TimGotzel/Stumpfkoerper-WS-18-19/README.md

# Stumpfkoerper-WS-18-19
Projektarbeit im WS 18/19 zum Thema: Experimentelle Untersuchung des Coandaeffekts zur Reduktion von Strömungsverlusten an D-Stumpfkörpern
