TimGotzel/Stumpfkoerper-WS-18-19/20_Bericht/04_widerstandsbestimmung.tex

\chapter{Mathematische Vorgehensweise (FT)}\label{s:widerstandsbestimmung}

%Das Ziel dieser Arbeit ist es, festzustellen, ob die hybride aktive Str"omungsbeeinflussung von stumpfen K"orpern mittels gepulster Druckluftjets "uber zwei rotierende Coand\^{a}-Walzen mit kleiner Zahnzahl an der K"orperr"uckseite eine nennenswerte Widerstandsreduktion gegen"uber dem Fall ohne Beeinflussung erzielt. 
%Dar"uber hinaus soll getestet werden, ob die periodische Aktuierung gegen"uber vorherigen Untersuchungen mit kontinuierlicher Ausblasung den Widerstand  st"arker senken kann und diese Form der Ausblasung als effizienter betrachtet werden kann.

Damit das Ziel der Arbeit erreicht werden kann, m"ussen aus den Versuchsdaten die jeweiligen Widerstandswerte des K"orpers bestimmt werden. Dar"uber hinaus ist es erforderlich, abzusch"atzen, ob die gew"ahlte Form der Str"omungsmodifikation unter dem Schlussstrich Energie einsparen kann, oder, ob f"ur die Aktuationsmechanismen m"oglicherweise sogar mehr Energie aufgewandt werden muss, als an Einsparung gewonnen werden kann.\\
Zus"atzlich ist es von Interesse zu bestimmen, wie gro\ss{} der Impulsstrom ist, der durch die Aktuation in die Str"omung eingebracht wird und diesen ad"aquat zu kennzeichnen. 

Die Gleichungen f"ur diese Zwecke sollen in diesem Kapitel hergeleitet und n"aher erl"autert werden.

\section{Bestimmung des Widerstands mittels des Impulssatzes}
\label{sec:WueberImpulssatz}
%Die nachfolgenden Ausf"uhrungen orientieren sich eng an  Hucho \cite{Hucho.2011}.
Wie in \kap{s:grundlagen} beschrieben, besteht die Widerstandskraft $W$ eines K"orpers innerhalb einer Unterschallstr"omung im Wesentlichen aus den beiden Anteilen Reibungswiderstand und Druckwiderstand:
	\begin{equation}
	\label{eq:W_zusammensetzung}
	W = W_R + W_D
	\end{equation}
Bei schlanken K"orpern dominiert der Reibungswiderstand $W_R$ der aus Schubspannungen in der Grenzschicht der Geometrie resultiert. Bei stumpfen K"orpern hingegen ist in fast allen F"allen der Druckwiderstand $W_D$ f"ur den gr"o\ss{}eren Anteil verantwortlich. $W_D$ hat seinen Ursprung wie bereits erw"ahnt in einer "uber den K"orper schwankenden Druckverteilung.  

Bei der Untersuchung in dieser Arbeit sollen diese beiden Anteile im Folgenden jedoch nicht explizit auseinandergehalten bzw. separat bestimmt werden, da dies f"ur das Aufzeigen und Quantifizieren des ver"anderten Verhaltens durch aktive Str"omungskontrolle nicht notwendig ist.  Wir behandeln im Folgenden also nur die gesamte Widerstandskraft.

Der Widerstand $W$ eines stumpfen K"orpers innerhalb einer Str"omung macht sich als Impulsverlust stromabw"arts der umstr"omten Geometrie bemerkbar~\cite{Hucho.2011}. In \abb{fig:HuchoKV} sieht man diesen Sachverhalt durch die Delle im Geschwindigkeitsverlauf hinter dem K"orper veranschaulicht. %Die Auspr"agung dieser Delle wird 

Aus diesen "Uberlegungen folgt, dass die gesuchte Gr"o\ss{}e $W$ bestimmt werden kann, indem der Geschwindigkeitsverlauf der Str"omung im Nachlauf betrachtet und mittels des Impulssatzes ausgewertet wird. 

Der Widerstand des K"orpers selbst l"asst sich also finden, wenn ein Kontrollvolumen wie in \abb{fig:HuchoKV} um den K"orper gelegt und eine Impulsbilanz aufgestellt wird~\cite{Hucho.2011}. Es wird im Folgenden vereinfacht von einer horizontalen, inkompressiblen 2D-Str"omung ausgegangen und der Impulssatz in x-Richtung

\begin{equation}
	\label{eq:impulssatz_allg}
	\rho \int_{(K)} u_x \, \mathrm{d}Q = F_{Kx} + F_{Px} + F_{Sx}
\end{equation}
betrachtet.

Die Dichte der umstr"omenden Luft wird hierbei mit $\rho$ und die x-Komponente des Geschwindigkeitsvektors mit $u_x$ und der "uber die Kontrollfl"ache tretende Volumenstrom mit $Q$ bezeichnet.
Zudem entspricht in \glg{eq:impulssatz_allg} $F_{Kx}$ den angreifenden Volumenkr"aften, $F_{Px}$ der am freien Teil des Volumen angreifenden Oberfl"achenkr"afte (Druckkraft) und $F_{Sx}$ der St"utzkraft.

\begin{figure}[h]
	\centering
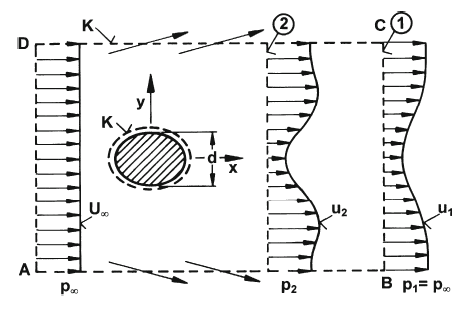
[picture p1: 20_Bericht/figures/KontrollvolumenHucho.PNG]
	
	\caption{Kontrollvolumen K um einen K"orper mit Geschwindigkeitsverteilungen u(x,y)~\cite{Hucho.2011}}
	\label{fig:HuchoKV}
\end{figure}

Die Volumenkraft $F_{Kx}$ kann dabei zu null gesetzt werden, da die Str"omung in Richtung x horizontal verl"auft und folglich kein Gravitationseinfluss ber"ucksichtigt werden muss. Auch abgesehen von der Gewichtskraft wirken keine anderen Volumenkr"afte.

Wenn das Kontrollvolumen, wie es in \abb{fig:HuchoKV} zu sehen ist, weit genug ab vom K"orper gelegt ist, herrscht an den Begrenzungr"andern AD, BC, AB und DC der konstante Druck $p_{\infty}$.
Dies resultiert in einer Druckkraft $F_{Px} = 0$, da sich die Kr"afte an den R"andern gegenseitig aufheben.

Infolgedessen kann die St"utzkraft nun also dem Nettoimpulsfluss gleichgesetzt werden, der
\begin{equation}
	\label{eq:nettoimpulsfluss}
	\rho \int_{(K)} \, u_x \, \mathrm{d}Q	= -\rho b \int u_1(U_{\infty} - u_1) \mathrm{d}y = F_{Sx}.	
\end{equation}
lautet.\\
Hier ist $b$ die Breite des Modells senkrecht zur Zeichenebene $u_1$ die Geschwindigkeit am Querschnitt (1) und  $U_{\infty}$ die Geschwindigkeit der umgest"orten Anstr"omung.

Die St"utzkraft des festen Teils des Kontrollvolumens - also des Stumpfk"orpers - h"angt mit dem Widerstand in der Form
\begin{equation}
	\label{eq:W=-F_Sx}
	W = - F_{Sx}
\end{equation}
zusammen.\\
$W$ ist also gleich der St"utzkraft mit negativem Vorzeichen.

Daraus folgt der Ausdruck f"ur den Widerstand zu
\begin{center}
	\begin{equation}
		\label{eq:widerstand}
		W = \rho b \int u_{1} (U_{\infty}- u_{1}) \mathrm{d}y.
	\end{equation}
\end{center}

Der Widerstand l"asst sich f"ur bessere Vergleichbarkeit dimensionslos "uber den Widerstandsbeiwert $C_w$ ausdr"ucken. Dieser ist als 
\begin{center}
	\begin{equation}
		\label{eq:def-c_w}
		C_w = \frac{W}{\frac{\rho}{2}\, U_{\infty}^2 \, bd}
	\end{equation}
\end{center}
definiert. Dabei wird der Widerstand auf die Str"omung und den charakteristischen K"orperquerschnitt $bd$ mit $d$ als H"ohe des Modells bezogen.

Nach Einsetzen der Gleichung \ref{eq:widerstand} ergibt sich f"ur den Widerstandsbeiwert
\begin{equation}
	\label{eq:Bestimmungsgleichung C_w}
	C_w = \frac{2}{U_{\infty}^2 d} \int u_{1}(U_{\infty} - u_{1}) dy.
\end{equation}
%Die Integrationsgrenzen m"ussen an die vertikale Ausdehnung der Sonden am Messrechen im Nachlauf angepasst werden.	

Um den Geschwindigkeitsverlauf zu bestimmen, k"onnen mehrere Methoden angewandt werden, wobei im Rahmen dieser Arbeit die Geschwindigkeiten aus den dynamischen Dr"ucken ermittelt werden.\\
Der Messrechen im Nachlauf liefert hierzu statische Dr"ucke und Totaldr"ucke.

Da die Wirbel an der K"orperr"uckseite periodisch abl"osen, erwarten wir am Ort der Messungen - sprich im Nachlauf - ebenfalls periodische Druckschwankungen.
Von Relevanz f"ur die zu untersuchenden Fragestellung sind dabei allerdings nur die Mittelwerte dieser Messungen "uber mehrere Perioden.
Diese werden fu"r die einzelnen Sonden in der Form
\begin{center}	
	\begin{equation}
		\overline{p}=\sum_{i=0}^{n}\frac{p_i}{n}
	\end{equation}
\end{center}
zeitlich gemittelt.
Die Summe aller "uber einen Zeitraum genommenen Dr"ucke $p_i$ wird hierbei durch die Anzahl $n$ dieser Dr"ucke innerhalb dieses Zeitraums geteilt.
Diese Mittlung gleicht zudem in gewissem Ma\ss{}e das unvermeidbare Messrauschen aus.

"Uber den die Definition des dynamischen Drucks $q$ bzw. den Zusammenhang
\begin{center}
	\begin{equation}
		\label{geschwindigkeitsformel}
		u_{1}(y)= \sqrt{\frac{2}{\rho}(p_t - p_{\infty}) } = \sqrt{\frac{2}{\rho} q(y)}
	\end{equation}
\end{center}
l"asst sich wie oben beschrieben der Geschwindigkeitsverlauf aus den gemessenen Dr"ucken bestimmen und in \glg{eq:Bestimmungsgleichung C_w} einsetzen. 

Wobei $p_t$ der Totaldruck, $p_{\infty}$ der statische Druck der freien Anstr"omung und $q$ der dynamische Druck ist.\\
Mit Hilfe dieser Formeln kann nun eine m"ogliche Reduktion des Widerstandsbeiwertes festgestellt werden.

Diese gesamte Vorgehensweise zur Bestimmung des Widerstands ist legitim, wenn an der Messstelle im Nachlauf n"aherungsweise angenommen werden kann, dass der statische Druck wieder $p_\infty$ entspricht.In diesem Fall heben sich die Druckterme im Impulssatz auf  beiden Seiten des Kontrollvolumens gegenseitig auf.
Wird die Nachlaufdelle hingegen n"aher am K"orper gemessen, weicht der dort gemessene statische Druck von $p_{\infty}$ ab.
Solche Abweichungen lassen sich durch die messtechnische Anordnung h"aufig nicht vermeiden - 
k"onnen nach \textit{B.M. Jones} aber durch eine Korrektur ber"ucksichtigt werden, wie sie beispielsweise bei \textit{Schlichting} \cite{Schlichting.2001} zu finden ist.

Hierbei werden die Dr"ucke, die theoretisch an einem Querschnitt (1) \abb{fig:HuchoKV} weit genug weg vom K"orper und somit von der statischen Druckabweichung herrschen, auf Dr"ucke zuruckgef"uhrt, die n"aher am K"orper tats"achlich gemessen werden\cite{Schlichting.2001}.
Der neue Querschnitt, bei welchem die Messung stattfindet, erh"alt den Index $(2)$.

Der Widerstand in diesem Fall ergibt sich zu
\begin{equation}
	\label{eq:widerstand_korrigiert}
	W = 2\,b \int \sqrt{p_{t2}(y) - p_2(y)} \left(\sqrt{p_{t\infty} - p_{\infty}} - \sqrt{p_{t2}(y) - p_{\infty}}\right) \mathrm{d} y_2 .
\end{equation}
Wobei $p_{t2}$ und $p_{t\infty}$ dem Totaldruck im Nachlaufquerschnitt respektive dem Totaldruck der ungest"orten Anstr"omung entspricht.

F"ur den Widerstandsbeiwert erh"alt man
\begin{equation}
	\label{eq:C_w_korrigiert}
	C_w = 2 \int_{(2)} \sqrt{\frac{p_{t2}(y) - p_2(y)}{q_{\infty}}}
	\left(1 - \sqrt{\frac{p_{t2}(y) - p_{\infty}}{q_{\infty}}}\right)  \mathrm{d}\left(\frac{y_{2}}{d}\right).
\end{equation}

Der Rechen, der die Dr"ucke liefert, sollte zu diesem Zwecke m"oglichst so platziert werden, dass die Nachlaufdelle komplett aufgenommen wird. 

Da nur diskrete Werte der jeweiligen Druckverteilung auf diese Weise ermittelt werden, m"ussen die Druckverteilungen durch eine Fitting-Funktion angen"ahert werden. 
Hierzu eignet sich - der bisherigen Erfahrung nach - der Ansatz

	\begin{equation}
	\label{eq:fitting-function}
	\frac{p(y) - p_{\infty}}{p_{min}-p_{\infty}} = (1 +ay^2)^{by^2}.
	\end{equation}
In \glg{eq:fitting-function} entspricht $p_{min}$ dem niedrigsten Druck im Nachlauf und $a$ und $b$ sind Modellparameter \cite{Oswald.2017}.

Diese Vorgehensweise hat sich beispielsweise bei einem "ahnlichem Modell durch \textit{Oswald} bew"ahrt \cite{Oswald.2017}.

Die \textit{Matlab}-Funktion \textit{nlinfit} wird hierbei genutzt, um die g"unstigsten Parameter f"ur die Druckverteilungen durch nichtlineare Regression zu bestimmen.\\
Die von \textit{nlinfit} ermittelten Druckverteilungen k"onnen dann zur Bestimmung des Widerstandsbeiwerts in \glg{eq:C_w_korrigiert} eingesetzt werden.\\
F"ur die Aufl"osung des Integrals wird die \textit{Matlab}-Funktion \textit{integral} genutzt, die globale adaptive Quadratur zur numerischen Bestimmung des Integralwerts einsetzt~\cite{Oswald.2017}.

Der vollst"andige \textit{Matlab}-Code zur Berechnung des Widerstandsbeiwerts und der Druckverteilungen ist in Anhang \ref{C_w-Code} zu finden. 

%---------------------------------------------------------------------------------------------------------------------------------------------------------------------------------
\section{Impulskoeffizient und Effizienzbetrachtung}

\subsection{Impulskoeffizient}
Der Impulskoeffizient $C_{\mu}$ wird als Ma\ss{} f"ur die Intensit"at der Ausblasung verwendet und ist im Falle von kontinuierlicher Ausblasung als 
\begin{equation}
	\label{eq: Def-momentum-coeff}
	C_{\mu} = \,\frac{\dot{m}_{jet} \cdot U_{jet}}{\frac{1}{2}\rho_{\infty}\, \cdot U^2_{\infty} \cdot A_{ref}}
\end{equation}
definiert~\cite{ElSayedM..2018}. 
Dabei entspricht $\dot{m}_{jet}$ dem Massenstrom, der durch die Spalte ausgeblasen wird. $U_{jet}$ bezeichnet die Geschwindigkeit dieses Ausblasestroms.
$A_{ref}$ wiederum dient als Bezugsfl"ache. Im Falle des getesteten Stumpfk"orpers wird als $A_{ref}$ die projizierte Fl"ache der K"orperh"ohe verwendet, da beispielsweise der Druckwiderstand einen proportionalen Zusammenhang zu dieser, f"ur stumpfe K"orper, charakteristischen Fl"ache besitzt.  %\cite{Bilges.2018}

Die Periodizit"at der Ausblasung, wie sie im Fall der zweiten Versuchskonfiguration auftritt, kann zus"atzlich im Impulskoeffizienten ber"ucksichtigt werden und f"uhrt letzendlich auf die Form \cite{Chabert.2014}
\begin{equation}
	\label{eq:momentum-coeff-oscill}
	\langle{C_{\mu}}\rangle = \frac{\rho_{jet}\langle{U^2_{jet}}\rangle \langle{A_{Spalt}}\rangle} {\frac{1}{2}\rho_{\infty}U^2_{\infty}A_{ref}}.	
\end{equation}
In \glg{eq:momentum-coeff-oscill} steht der $\langle{}\rangle$-Operator f"ur die jeweiligen zeitlichen Mittelwerte und $A_{Spalt}$ bezeichnet die Fl"ache des Ausblasespalts.

Da sowohl Plenumsdruck und somit auch die Ausblasegeschwindigkeit $U_{jet}$, als auch der Spaltquerschnitt "uber die Umdrehung der Walzen schwanken, m"ussen diese Einfl"usse wie in \glg{eq:momentum-coeff-oscill} Eingang in die Formel f"ur $C_{\mu}$ im Falle der periodischen Aktuation finden.

F"ur das mit der Zeit variierende $A_{Spalt}$   wird die mittlere Spalth"ohe, die sich von dem Zeitpunkt der "Offnung des Spalts bis zu dem Zeitpunkt, an dem der Spalt gerade wieder geschlossen ist, ermittelt.  
Durch die Betrachtung des in \kap{s:rotierendeWalzen} in \abb{fig:signal} dargestellten Spalth"ohenverlaufs ergibt sich ein $\langle{h_{Spalt,offen}}\rangle$ von ca. 0,19 \,mm.

Die mittlere Spalth"ohe "uber eine komplette Umdrehung ergibt sich durch die Multiplikation mit dem Tastgrad $\alpha$.

$U_{jet}$ muss im Falle der neu erprobten Testkonfiguration mit ovalen Wellen "uber die Plenumsdr"ucke berechnet werden.
Zun"achst werden aus den kontinuierlich ermittelten Messwerten f"ur die beiden Dr"ucke $p_{Plenum}$ mittlere Werte gebildet, die als Ausgangspunkt der Berechnung dienen.

Wir gehen weiterhin davon aus, dass der im Plenum vorhandene Druck vollst"andig in dynamischen Druck umgesetzt wird:
	\begin{equation}
	\label{eq:Annahme q}
		\langle{p_{Plenum}}\rangle = q_{jet}
	\end{equation}
In\glg{eq:Annahme q} ist $q_{jet}$ der dynamische Druck des Druckluftjets.

Da wir eine inkompressible Str"omung annehmen, kann die Geschwindigkeit $\langle{U_{jet}}\rangle$ nun als
	
	\begin{equation}
	\label{eq:jetgeschwindigkeit}
		\langle{U_{jet}}\rangle = \sqrt{\frac{2 \langle{p_{Plenum}}\rangle}{\rho_{jet}}} = \sqrt{\frac{2 \langle{p_{Plenum}}\rangle}{\rho_{\infty}}}
	\end{equation}
ausgedr"uckt werden.

Dar"uber hinaus muss wie bereits erw"ahnt der Tastgrad (\textit{engl}: duty cycle) des Signals der Walzen $\alpha$  mitbetrachtet werden.
Bei den getesteten Walzen folgt f"ur 50\,\% Tastgrad, dass die Ausblasung zumindest theoretisch exakt "uber die H"alfte einer Walzenumdrehung erfolgt.
%Daraus folgt f"ur den Impulskoeffizient mit Ber"ucksichtigung der Periodizit"at die Gleichung
%\begin{equation}
%	\label{eq:momentum-coeff-oscill-alpha}
%	\langle{C_{\mu}}\rangle = \alpha C_{\mu}
%\end{equation}	 

Wenn nun zus"atzlich bedacht wird, dass "uber zwei als gleich angen"aherte Spalte ausgeblasen wird, k"urzt sich dieser Faktor 2 genau mit dem Tastgrad und wir erhalten als modifizierten Impulskoeffizienten f"ur die zweite Testkonfiguration

	\begin{equation}
	\label{eq:momentum-coeff-oscill-final}
		\langle{C_{\mu}}\rangle = \frac{\rho_{jet}\langle{U^2_{jet}}\rangle \langle{A_{Spalt}}\rangle} {\frac{1}{2}\rho_{\infty}U^2_{\infty}A_{ref}} = \frac{2\langle{p_{Plenum}}\rangle \langle{h_{Spalt,offen}}\rangle \cdot b_{Spalt}} {\frac{1}{2}\rho_{\infty}U^2_{\infty}A_{ref}}
	\end{equation}

Mittels des Impulskoeffizienten kann die Effektivit"at der Ausblasung beschrieben werden.
Auch f"ur den Vergleich zwischen den untersuchten Walzenpaaren und mit den Daten von \textit{Bilges} \cite{Bilges.2018} ist die Betrachtung des Impulskoeffizienten ma\ss{}geblich.

\subsection{Leistungskoeffizient und Leistungsrate}
Eine alleinige Betrachtung und ein Vergleich der $C_w$-Werte f"ur den Fall ohne Druckluftzuf"uhrung und rotierende Walzen, sowie den Fall mit aktiver konstanter sowie periodischer Stro"mungsbeeinflussung ist nicht ausreichend, um eine vollst"andige Bewertung der unterschiedlichen Konfigurationen vorzunehmen.

Die durch eine Widerstandsreduktion bedingte Leistungseinsparung im Anwendungsfall k"onnte durchaus durch die extern aufzubringende Leistung f"ur Druckluft und Walzenrotation ausgeglichen oder "ubertroffen werden, sodass letztendlich zus"atzliche Energie aufgebracht und der Zweck der Anwendung verfehlt w"urde.

Ob diese Form der Str"omungsbeeinflussung also eine reale Netto-Leistungseinsparung zur Folge hat, muss folglich durch andere Kennzahlen quantifiziert werden.

Zun"achst verwenden wir f"ur die Effizienzbetrachtung eine Leistungsrate $PR$, die als 

\begin{equation}
	\label{eq:leistungsrate}
	PR = \frac{(W_0 - W)\cdot U_{\infty}}{\frac{1}{2} \dot{m_j} u_j^2 + \, P_M}
\end{equation}
eingef"uhrt wird~\cite{Freund.1994}.

Der Z"ahler dr"uckt die eingesparte Widerstandsleistung des Falls mit aktiver Str"omungsbeeinflussung im Vergleich mit dem neutralen Fall aus.
Dieser Term quantifiziert somit, in welchem Umfang die Energiedissipation in der Str"omung im zweiten Versuch reduziert wird.

Der Nenner repr"asentiert hingegen die Leistung welche dem Modell bzw. der Str"omung von externer Quelle zugef"uhrt werden muss, um den gew"unschten Effekt zu erzielen.

Der erste Summand $\frac{1}{2}\,\dot{m_j} u_j^2$ charakterisiert die kinetische Leistung der Druckluft-Jets, die durch die Spalte ausgeblasen werden. Diese Darstellung vernachl"assigt, dass die  Druckluftbeaufschlagung in den Leitungen Verluste mit sich tr"agt und auch der Kompressor selber keinen optimalen Wirkungsgrad besitzt. Somit handelt es sich bei diesem Term um die idealisierte Jet-Leistung.

Der zweite Summand $ P_M$ ist die kombinierte Motorleistung und tr"agt dem Zustand Rechnung, dass die rotierenden Walzen von zwei Elektromotoren angetrieben werden m"ussen. Diese sind f"ur den Ausgleich der an den Walzen auftretenden Widerst"anden wie Reibung an den Lagern zust"andig.
Diese Leistung wird mittels eines Leistungsmessger"ats ermittelt und manuell f"ur die Versuchsreihen notiert.

Eine negative Leistungsrate kennzeichnet F"alle in denen der Widerstand gegen"uber der Referenzmessung gestiegen ist. Eine positive Leistungsrate unterhalb von $1$ ergibt sich bei Konfigurationen, bei denen zwar der Widerstand durch die Aktuation gesenkt werden, dieser Gewinn die Kosten aber nur anteilig ausgleichen kann.\\
Erst bei Leistungsraten oberhalb von $PR = 1$ wird durch die aktiven Ma\ss{}nahmen zur Widerstandsreduzierung eine tats"achliche Leistungsersparnis generiert.

Mit \glg{eq:def-c_w} kann man die Leistungsrate auch als
\begin{equation}
	\label{eq:leistungsrate_cw}
	PR = \frac{(C_{W0} - C_W)\cdot \frac{\rho_{\infty}}{2} U^3_{\infty}\,A_{ref}}{\frac{1}{2} \dot{m_j} u_j^2 + \, P_M}
\end{equation}
schreiben.

Des Weiteren wird noch als Gr"o\ss{}e der Leistungskoeffizient $C_{Power}$ ben"otigt, welcher als
\begin{equation}
	\label{eq:def-powercoefficient}
	C_{Power,jet} = \frac{E_{jet}\dot{m}_{jet} + p_{jet}U_{jet}A_{jet} - (E_p\dot{m}_p + p_p U_p A_p)}{\frac{1}{2}\rho_{\infty}U^3_{\infty} A_{ref}}
\end{equation}

mit
\begin{equation}
	\label{eq:def-energieterm}
	E = c_vT + \frac{U^2}{2}
\end{equation}		
definiert ist~\cite{Hucho.2011}.

Gr"o\ss{}en mit Index $p$ entsprechen dabei den Gr"o\ss{}en innerhalb des Plenums, in dem die Str"omung nicht kontrahiert wird.
Des Weiteren bezeichnet $c_v$ die spezifische W"armekapazit"at von Luft bei konstantem Volumen, $T$ die Temperatur der Luft und $U$ die Geschwindigkeit.

Dieser Koeffizient dr"uckt das Verh"altnis der aufzubringenden Leistung durch die Aktuation zur in der Antsr"omung vorhandenen Leistung aus.

Im Rahmen dieser Versuche wenden wir auf \glg{eq:def-powercoefficient} einige Vereinfachungen an. 

Zun"achst treffen wir die Annahmen, dass die Temperatur innerhalb des ausgeblasenen Luftstroms gleich der Temperatur im Plenum ist
	\begin{equation}
	\label{eq:T-Vereinfachung}
		T_{jet} = T_{Plenum}
	\end{equation}
und wir n"aherungsweise davon ausgehen k"onnen, dass im Plenum keine Str"omungsgeschwindigkeit 
	\begin{equation}
	\label{eq:Up}
		U_{Plenum} \approx 0
	\end{equation}
vorliegt.

Des Weiteren nehmen wir, wie zuvor, an, dass die Str"omung inkompressibel ist und somit
	\begin{equation}
	\label{eq:Inkompressibilitaet}
		\rho_{jet} = \rho_{Plenum} = \rho_{\infty}
	\end{equation}
gilt.

Damit folgt f"ur den Leistungskoeffizienten der Ausblasung

	\begin{equation}
	\label{eq:CPowerJ vereinfacht}
		C_{Power,Jet} = \frac{\frac{1}{2}\,U^2_{jet} \cdot \dot{m}_{jet} \, + p_{jet}U_{jet}A_{jet}}{\frac{1}{2}\rho_{\infty}U^3_{\infty}A_{ref}}.
	\end{equation}

Im Falle periodischer Ausblasung muss anstatt $A_{jet}$ wieder $\langle{A_{jet}}\rangle$ verwendet werden.

Neben der Ausblasung wird auch der Aktuation durch die Walzen ein Leistungskoeffizient zugewiesen, welcher als
		\begin{equation}
		\label{eq:def-CPowerM}
			C_{Power,M} = \frac{P_M}{\frac{1}{2}\rho_{\infty}U^3_{\infty}A_{ref}}
		\end{equation}
		
definiert wird.
$P_M$ entspricht hierbei wie zuvor der kombinierten Leistung der beiden Motoren.
