TimGotzel/Stumpfkoerper-WS-18-19/20_Bericht/00_eid_erkl.tex

\chapter*{Eidesstattliche Erkl"arung}\label{s:eid_erkl}

Wird eine eidesstattliche Erkl"arung ben"otigt?

%Hiermit erkl"are ich, Vorname Familienname, geb. am xx.yy.zzzz, des Eides
%statt, die vorliegende Diplom-/Master-/Bachelor-Arbeit selbstst"andig und ohne
%fremde Hilfe verfasst und keine anderen als die angegebenen Hilfsmittel verwendet zu
%haben.
%
%\vspace*{3cm}
%Braunschweig, xx.yy.zzzz
