TimGotzel/Stumpfkoerper-WS-18-19/20_Bericht/00_frontpage.tex

\begin{titlepage}
 \centering

\begin{table}[htbp]
 \begin{center}
 \vspace{-0.5cm}
% \renewcommand{\arraystretch}{1.5}
  \begin{tabular}{lcr} 
    \parbox{0.45\textwidth}{\mbox{ }} & \parbox{0.13\textwidth}{\mbox{ }} & \parbox{0.45\textwidth}{\mbox{ }} \\
    \hspace*{-2.0cm}
     & 
     &  \\ %empty
  \end{tabular}
 \end{center}
\end{table}

 \vspace*{2.0cm}

 \textbf{\large Projektarbeit}

 \vspace*{1.5cm}
 
 \textbf{\LARGE Experiment am D-f"ormigen Stumpfk"orper} \\[0.5ex]

 \vspace*{1.5cm}

 \textbf{\large Nora M. Bierwagen (Matr.-Nr. 4754262)} \\
 \textbf{\large Tim Gotzel (Matr.-Nr. 4839608)} \\
 \textbf{\large Amiriman Kianfar (Matr.-Nr. 4844004)} \\
 \textbf{\large Kebria Kiani (Matr.-Nr. 4676955)} \\
 \textbf{\large Florian Timm (Matr.-Nr. 4795072)} \\

 \vspace*{7.0cm}

 \begin{table}[htbp]
  \begin{center}
%  \renewcommand{\arraystretch}{1.5}
   \begin{tabular}{rl} 
     \parbox{0.33\textwidth}{\mbox{ }} & \parbox{0.66\textwidth}{\mbox{ }} \\
     Ausgegeben:%& Jun.-Prof. Dr.-Ing. D. Ko{\v z}ulovi{\' c} \\
                 & Institut f\" ur Str\" omungsmechanik \\
                 & Institutsleiter: Prof. Dr.-Ing. R. Radespiel \\
                 & Technische Universit\" at Braunschweig \\
                 &  \\
       Betreuer: %& Dipl.-Ing. X Y, (externe Firma) \\
                 & M.Sc. Philipp Oswald, (TU Braunschweig) \\
           %      &  \\
 %(Erstellt bei:) & (Externe Firma, Stadt) \\
                 &  \\
 Ver"offentlichung: & \today \\
   \end{tabular}
  \end{center}
 \end{table}

\end{titlepage}
