TimGotzel/Stumpfkoerper-WS-18-19/70_Poster/PAPoster.pptx

TUBraunschweig_CO_360vH_PPT_Poster

Institut für Strömungsmechanik

Widerstandsreduzierung am Stumpfkörper durch kombinierte, periodische Strömungsaktuierung
N. M. Bierwagen, T. Gotzel, A. Kianfar, K. Kiani, F. Timm
Technische Universität Braunschweig | Institut für Strömungsmechanik
Betreuer: M.Sc. Philipp Oswald, philipp.oswald@tu-braunschweig.de

Rotierende Walzen
Material PTFE & Aluminium
Durchmesser (maximal) 16,6 mm
Maximale Spaltöffnung 0,3 mm
Anzahl der Zähne 2
Duty Cycle 50%

Ergebnisse
Tendenz zu Widerstandsreduktionen im
Bereich oberhalb der natürlichen Ablöse-
Frequenz für gewisse Ausblaseparameter
Wegen hoher Reibungswiderstände keine
Leistungseinsparung durch Aktuations-
mechanismen
Abrieb an den Teflonwalzen


Stumpfkörper
Totwassergebiet mit Nachlauf durch zweiseitige Scherschicht
Hoher Druckwiderstand durch Druckabsenkung im Totwasser
Alternierend oszillierende Wirbelbildung
Strouhal-Zahl: Str= (f∙D)/(U_(∞))≈0,23
Nachlauf mit Informationen über
Druckwiderstand
Ziel:
Druckerhöhung im Totwasser
Hybride Aktuierung
      - Rotierende Walzen
      - Periodische Coandâ-Flächen
Ausblasung

Graphik aus: W.-H. Hucho. Aerodynamik der stumpfen Körper: Physikalische Grundlagen und Anwendungen in der Praxis. Strömungsmechanik. Vieweg + Teubner, Wiesbaden, 2., vollst. überarb. und erw. au. edition, 2011.


Widerstandsermittlung
Ermittlung der Druckverteilungen im Nachlauf des Modells durch Messrechen
Festlegung eines Kontrollvolumens
Aufstellen und Auswerten des Impulssatzes:
C_W =2∫_((2)) √((p_(t2) (y)−p_2 (y))/(q_(∞)))(1− √((p_(t2) (y)−p_(∞))/(q_(∞))))
Variation der Walzendrehzahl n und des Impulskoeffizienten C_μ


Graphik aus: W.-H. Hucho. Aerodynamik der stumpfen Körper: Physikalische Grundlagen und Anwendungen in der Praxis. Strömungsmechanik. Vieweg + Teubner, Wiesbaden, 2., vollst. überarb. und erw. au. edition, 2011.

Ausblick
Wechsel des Materials bzw. der Materialkombination am Ausblasespalt
Phasengleichheit der Walzen sicherstellen
Variation Zahnformen
Variation der Anzahl der Zähne
Variation des duty cycles
LKW-Modell mit Bodeneffekten

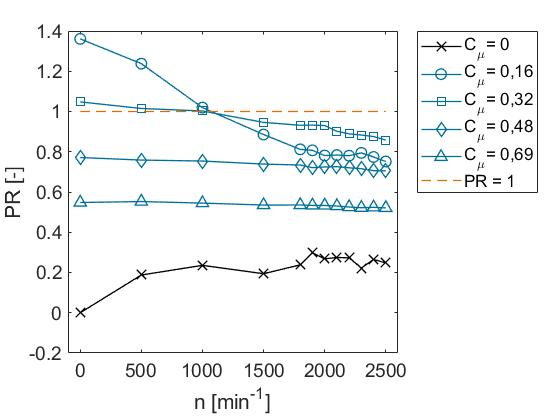
[picture p8: figure]
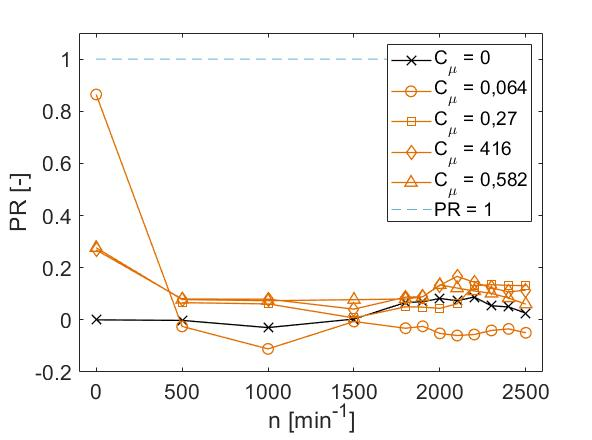
[picture p9: figure]
