TimGotzel/Stumpfkoerper-WS-18-19/20_Bericht/00_nomenklatur.tex

\chapter*{Nomenklatur}
\addcontentsline{toc}{chapter}{Nomenklatur}
%ALPHABETISCH SORTIEREN!

\subsection*{Lateinische Bezeichnungen}
\begin{tabbing}
\hspace*{2cm}\=\kill
%$AVDR$ \> axiales Stromdichteverh\"altnis \\[0.2ex]
$A$ \> Fl"ache/Querschnitt \\[0.2ex]
$b$ \> Breite des Modells senkrecht zur Zeichenebene \\[0.2ex]
$C_{Power}$ \> Leistungskoeffizient \\[0.2ex]
$C_w$ \> Widerstandsbeiwert \\[0.2ex]
$C_{\mu}$ \> Impulskoeffizient \\[0.2ex]
$D$ \> Dicke bzw. H"ohe des Stumpfk"orpers \\[0.2ex]
$dp$ \> Druckgradient \\[0.2ex]
$f$ \> Frequenz \\[0.2ex]
$F$ \> Kraft \\[0.2ex]
$F_{K}$ \> Volumenkr"afte \\[0.2ex]
$F_{P}$ \> Druckkr"afte \\[0.2ex]
$F_{S}$ \> St"utzkraft \\[0.2ex]
$H$ \> Strahlh"ohe \\[0.2ex]
$K$ \> Kontrollfl"ache \\[0.2ex]
$\dot{m}$ \> Massenstrom \\[0.2ex]
$n$ \> Drehzahl \\[0.2ex]
$P_M$ \> Motorleistung \\[0.2ex]
$p$ \> statischer Druck \\[0.2ex]
$p_t$ \> Totaldruck \\[0.2ex]
$p_Plenum$ \> Plenumsdruck \\[0.2ex]
$Q$ \> Volumenstrom \\[0.2ex]
$q$ \> Dynamischer Druck \\[0.2ex]
$R$ \> Radius der Coand\^{a}-Kontur \\[0.2ex]
$Str$ \> Strouhal-Zahl \\[0.2ex]
$U_{\infty}$ \> Anstr"omungsgeschwindigkeit \\[0.2ex]
$u_1$ \> Str"omungsgeschwindigkeit in x-Richtung \\[0.2ex]
$W$ \> Widerstand \\[0.2ex]
$x$ \> Koordinate in Str"omungsrichtung \\[0.2ex]
$y$ \> Koordinate senkrecht zur Str"omungsrichtung \\[0.2ex]
\end{tabbing}

\subsection*{Griechische Bezeichnungen}
\begin{tabbing}
\hspace*{2cm}\=\kill
$\alpha$ \> Tastgrad (\textit{engl.}: duty cycle) \\[0.2ex]
%$\beta$ \> Winkel in Umfangsrichtung \\[0.2ex]
$\lambda$ \> Schlankheitsgrad \\[0.2ex]
$\rho$ \> Dichte \\[0.2ex]
$\sigma$ \> Dickenverh"altnis \\[0.2ex]

\end{tabbing}

\subsection*{Indizes}
\begin{tabbing}
\hspace*{2cm}\=\kill
%$ax$ \> in axiale Richtung \\[0.2ex]
$\infty$ \> Freie Anstr"omung \\[0.2ex]
$0$ \> Bezugsr"o\ss{}e \\[0.2ex]
$1$ \> Gr"o\ss{}e im Str"omungsquerschnitt des Nachlaufs weit ab vom K"orper \\[0.2ex]
$2$ \> Gr"o\ss{}e im Str"omungsquerschnit in dem der Rechen angeordnet ist \\[0.2ex]
$C$ \> Gr"o\ss{}e an Zylinder \\[0.2ex]
$ref$ \> Referenzgr"o\ss{}e \\[0.2ex]
$jet$ \> Gr"o\ss{}e bez"uglich des augeblasenen d"unnen Luftstrahls (Jet) \\[0.2ex]
$M$ \> Gr"o\ss{}e bez"uglich der Motoren \\[0.2ex]
\end{tabbing}

\subsection*{Abk\"urzungen}
\begin{tabbing}
\hspace*{2cm}\=\kill
%$CFD$ \> \underline{C}omputational \underline{F}luid \underline{D}ynamics \\[0.2ex]
$NB$ \> \underline{N}ora M. \underline{B}ierwagen \\[0.2ex]
$TG$ \> \underline{T}im \underline{G}otzel \\[0.2ex]
$AK$ \> \underline{A}miriman \underline{K}ianfar \\[0.2ex]
$KK$ \> \underline{K}ebria \underline{K}iani \\[0.2ex]
$FT$ \> \underline{F}lorian \underline{T}imm \\[0.2ex]
%$MATLAB$ \> kommerzielle Software zur L"osung mathematischer Probleme\\[0.2ex]

$PR$ \> Leistungsrate \\[0.2ex]
$rpm$ \> Umdrehungen pro Minute \\[0.2ex]
\end{tabbing}
