TimGotzel/Stumpfkoerper-WS-18-19/20_Bericht/anhang2.tex

\chapter{MATLAB-Code (AK, FT)}
\label{c:Anhang B}

\section{Bestimmung der Druckverteilungen und des Widerstands}
\label{C_w-Code}
\begin{figure}[h]
	\centering
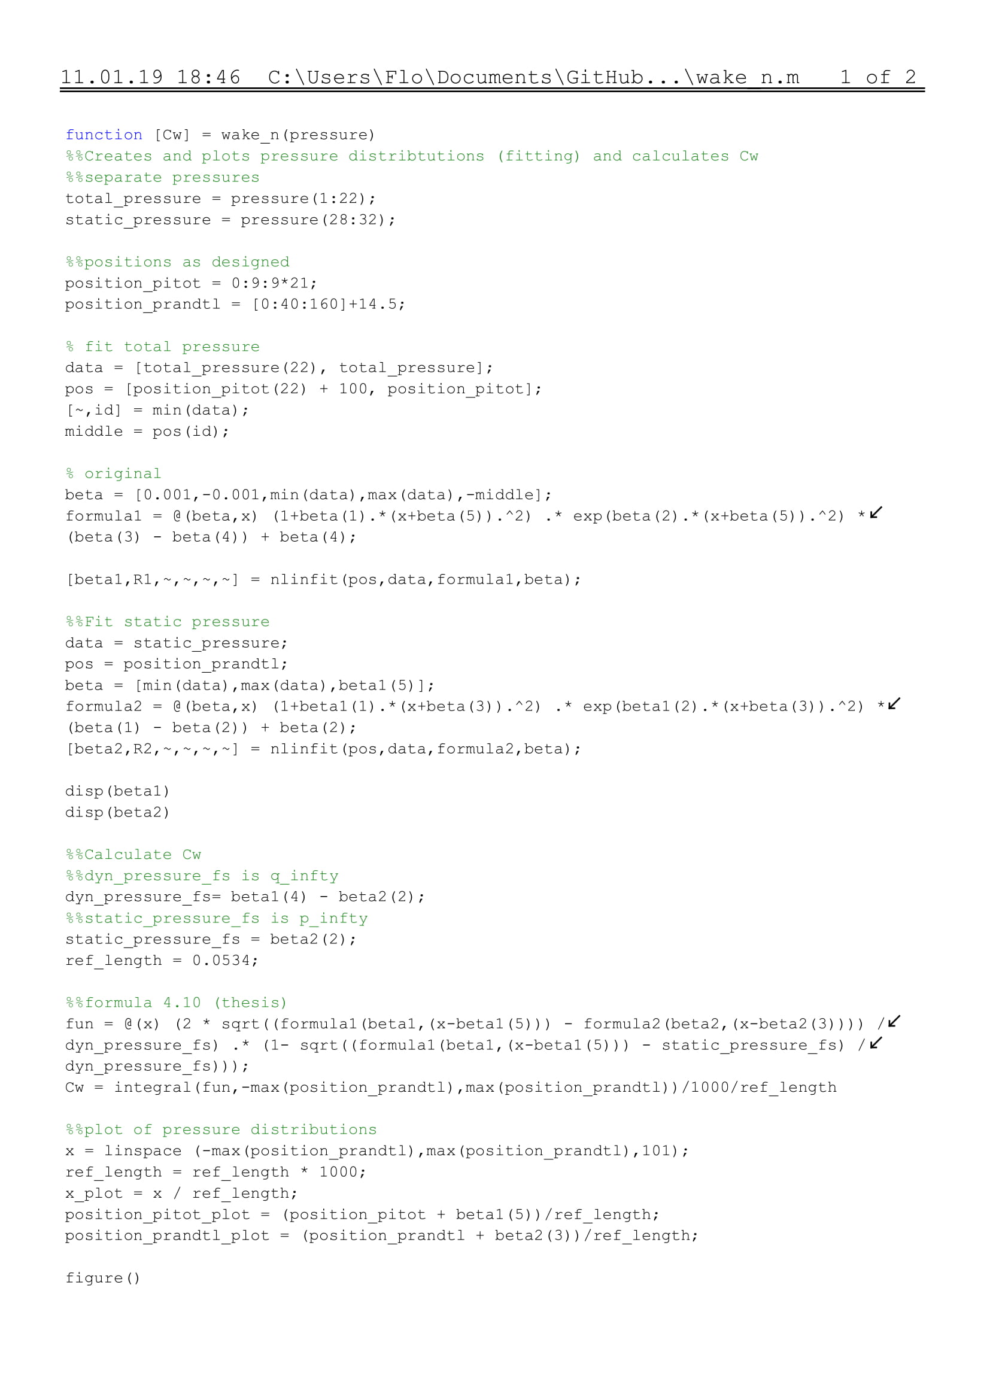
[picture p71: 20_Bericht/figures/wake_n-1.jpg]
	
	\label{fig:C_w-Code}
\end{figure}
\begin{figure}
	\centering
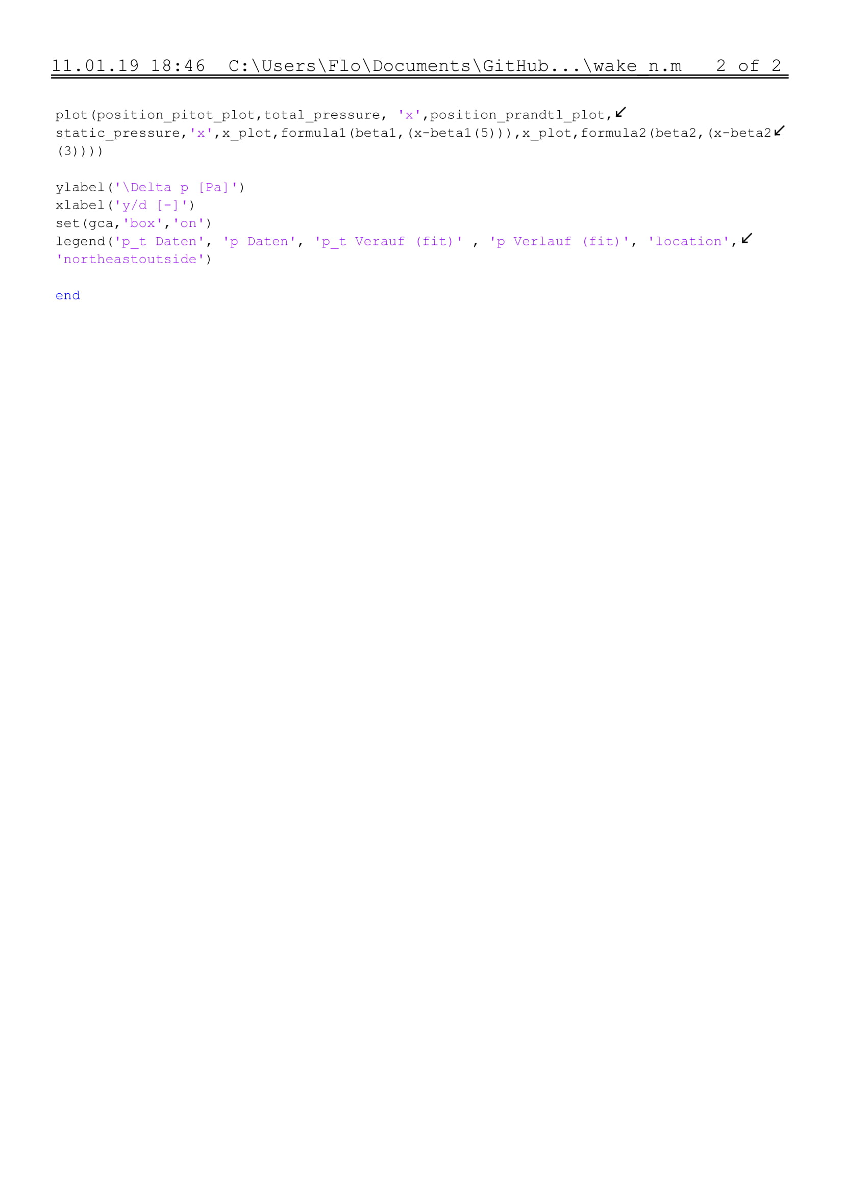
[picture p72: 20_Bericht/figures/wake_n-2.jpg]
	
\end{figure}
