TimGotzel/Stumpfkoerper-WS-18-19/20_Bericht/Berichtgliederung.docx

Berichtgliederung

Formelzeichen

Einleitung/Fragestellung

1. Grundlagen
  a. Stumpfkörperaerodynamik
  b. Coandâ-Effekt
  c. Aktive/passive Strömungsbeeinflussung
2. Rotierende Walzen
  a. Geometrie
  b. Konstruktion
  c. Motor
3. Widerstandsbestimmung
4. Windkanalversuche
  a. Windkanal
  b. Versuchsaufbau
  c. Messeinrichtungen
  d. Versuchsdurchführung
5. Versuchsauswertung
  a. Messdaten
  b. Vergleich mit Erwartungen
  c. Vergleich zum Modell ohne Walzen
  d. Effizienzbetrachtung
6. Fazit
7. Appendix
