TimGotzel/Stumpfkoerper-WS-18-19/90_Widerstandsbestimmung/Formeln zur Widerstandsbestimmung.pdf

# Kapitel 1

# Widerstandsbestimmung

Das Ziel dieser Arbeit ist es, festzustellen, ob die aktive Strömungsbeeinussung von stumpfen Körpern mittels gepulster Druckluftjets über zwei rotierende Coanda-Walzen an der Körperrückseite eine nennenswerte Widerstandsreduktion gegenüber dem Fall ohne Beeinussung erzielt.

Hierzu muss aus den Versuchsdaten einerseits die jeweiligen Widerstandswerte des Körpers bestimmt werden. Andererseits ist es erforderlich, abzuschätzen, ob diese Form der Strömungsmodikation unter dem Schlussstrich Energie einsparen kann oder für die Aktuationsmechanismen möglicherweise sogar mehr Energie aufgewandt werden muss, als an Einsparung gewonnen werden kann.

Die Gleichungen für diese Zwecke sollen in diesem Kapitel hergeleitet und erläutert werden.

## 1.1 Bestimmung des Widerstands mittels des Impulssatzes

Die nachfolgenden Ausführungen orientieren sich eng an Huchos Aerodynamik der stumpfen Körper (S.52 .).

Der Widerstand des umströmten Stumpfkörpers kann ermittelt werden, in dem der Geschwindigkeitsverlauf der Strömung im Nachlauf betrachtet und ausgewertet wird.

Die Messung im Windkanal im Nachlauf liefert hierzu diverse Drücke - statische und dynamische.

Damit wir unser vereinfachtes mathematisches Modell auf die Versuchsdaten anwenden können, müssen die Drücke der einzelnen Sonden in der Form

p =

Xn

i=0

pi
n

(1.1)

zeitlich gemittelt werden. Die Summe aller über einen Zeitraum genommenen Drücke pi wird hierbei durch die Anzahl n dieser Drücke innerhalb dieses Zeitraums geteilt.

Über den die Denition des dynamischen Drucks q bzw. den Zusammenhang

u1(y) = s

ρ

(pg − p∞) = s

ρ

q(y) | (1.2)

lässt sich der Geschwindigkeitsverlauf aus den gemessenen Drücken bestimmen.

Wobei u1 die Strömungsgeschwindigkeit im Nachlauf in Abhängigkeit der y-Koordinate und q der gemessene dynamische Druck ist.

Der Widerstand des Körpers selber lässt sich nun nden, wenn ein Kontrollvolumen um den Körper gelegt und der Impulssatz in x-Richtung nach der resultierenden Druckkraft ausgewertet wird, wobei der Ausdruck für den Widerstand

W = ρb Z +y

−y

u1(U∞ − u1)dy | (1.3)

wird. Hier ist b die Breite des Modells senkrecht zur Zeichenebene, ρ die Dichte der umströmenden Luft und U∞ die Geschwindigkeit der umgestörten Anströmung.

Diese Vorgehensweise ist legitim, wenn an der Messstelle im Nachlauf näherungsweise angenommen werden kann, dass der statische Druck wieder p∞ entspricht und sich die Druckterme im Impulssatz auf beiden Seiten des Kontrollvolumens gegenseitig aufheben.

Des Weiteren ist der dimensionslose Widerstandsbeiwert Cw als

Cw =

W
ρ
2

U

2
∞bd | (1.4)

deniert.

Nach Einsetzen der Gleichung 1.3 ergibt sich für den Widerstandsbeiwert

Cw =

2
U²∞d

Z +y

−y

u1(U∞ − u1)dy. | (1.5)

Die Integrationsgrenzen müssen an die vertikale Ausdehnung der Sonden am Messrechen im Nachlauf angepasst werden.

Mit Hilfe dieser Formeln kann dann ein mögliche Reduktion des Widerstandsbeiwertes für den Versuch mit rotierenden Walzen festgestellt werden.

Wird die Nachlaufdelle hingegen näher am Körper gemessen, weicht der dort gemessene statische Druck von p∞ ab. Dies kann nach B.M. Jones[Zitat] durch eine Korrektur berücksichtigt werden.

Der neue Querschnitt in der StrÃ¶mung erhält den Index (2).

Die korrigierten Terme sollen hier lediglich angegeben werden. Für eine ausführlichere Darstellung sei auf die ausgewiesene Literatur verwiesen[Zitat].

Der Widerstand in diesem Fall ergibt sich zu

W = 2b

Z √
pt2 − p2(

√
pt∞ − p∞ −

√
pt2 − p∞)dy2. | (1.6)

Wobei pt2 und pt∞ dem Totaldruck im Nachlaufquerschnitt bzw. dem Totaldruck der ungestörten Anströmung entspricht.

Für den Widerstandsbeiwert erhält man

Cw = 2 Z

(2) s
pt2 − p2
q∞

(1 −

s
pt2 − p∞
q∞

d(

y
d
). | (1.7)

## 1.2 Ezienzbetrachtung und Impulskoezient

Eine alleinige Betrachtung und ein Vergleich der Cw-Werte für den Fall ohne Druckluftzuführung und rotierende Walzen, sowie den Fall mit aktiver Stromungsbeeinussung ist allerdings nicht ausreichend.

Die durch eine Widerstandsreduktion bedingte Leistungseinsparung im Anwendungsfall könnte durchaus durch die extern aufzubringende Leistung für Druckluft und Walzenrotation ausgeglichen oder übertroen werden, sodass letztendlich zusätzliche Energie aufgebracht und der Zweck der Anwendung verfehlt würde.

Ob diese Form der Strömungsbeeinussung also eine reale Netto-Leistungseinsparung zur Folge hat, muss folglich durch eine andere Kennzahl quantiziert werden.

Zunächst verwenden wir für die Ezienzbetrachtung einen Leistungskoezienten, der als

P C =

(W0 − W) · u∞

1
2m˙ ju

2
j + 2PM

(1.8)

eingeführt wird.

Der Zähler drückt die eingesparte Widerstandsleistung des Falls mit aktiver Strömungsbeein-ussung im Vergleich mit dem neutralen Fall aus. Dieser Term quantiziert somit, in welchem Umfang die Energiedissipation in der Strömung im zweiten Versuch reduziert wurde.

Der Nenner hingegen repräsentiert hingegen die Leistung welche dem Modell bzw. der Strömung von externer Quelle zugeführt werden muss, um den gewünschten Eekt zu erzielen.

Der erste Summand 1
2m˙ ju

2
j

charakterisiert die kinetische Leistung der Druckluft-Jets, die durch die Spalte ausgeblasen werden. Diese Darstellung vernachlässigt, dass die Druckluftbeaufschlagung in den Leitungen Verluste mit sich trägt und auch der Kompressor selber keinen optimalen Wirkungsgrad besitzt. Somit handelt es sich bei diesem Term um die idealisierte Jet-Leistung.

Der zweite Summand trägt dem Zustand Rechnung, dass die rotierenden Walzen von zwei Elektromotoren angetrieben werden müssen.

Impulskoezient (Folgt später)
