TimGotzel/Stumpfkoerper-WS-18-19/10_Projektmanagement/Datenblatt Motor.jpg

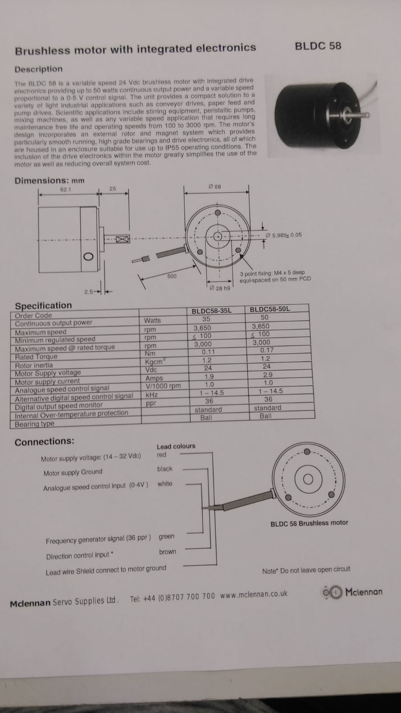
10_Projektmanagement/Datenblatt Motor.jpg
