TimGotzel/Stumpfkoerper-WS-18-19/10_Projektmanagement/Skizze.jpg

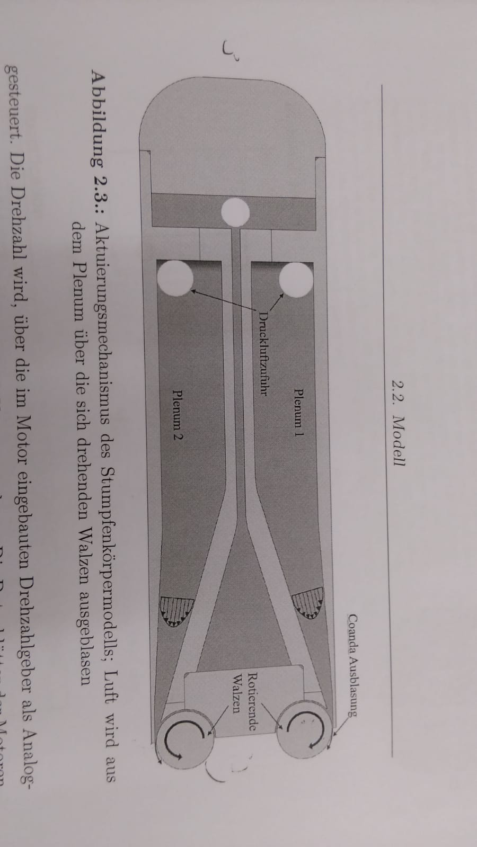
10_Projektmanagement/Skizze.jpg
