TimGotzel/Stumpfkoerper-WS-18-19/10_Projektmanagement/Zeitplan.JPG

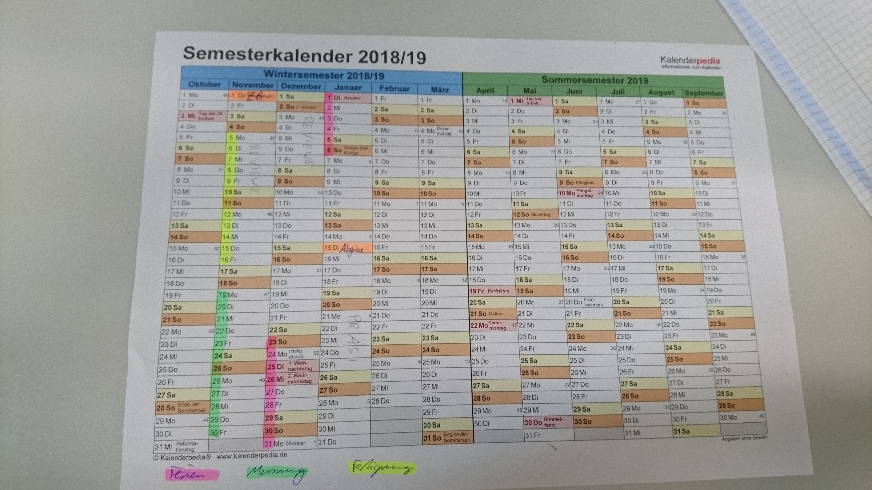
10_Projektmanagement/Zeitplan.JPG
