TimGotzel/Stumpfkoerper-WS-18-19/20_Bericht/figures/CwCwrefn_ueberCPowerJ_fuerCPowerM_RK.jpg

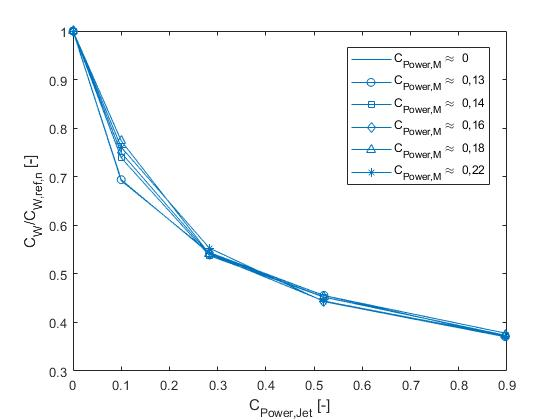
20_Bericht/figures/CwCwrefn_ueberCPowerJ_fuerCPowerM_RK.jpg
