TimGotzel/Stumpfkoerper-WS-18-19/20_Bericht/figures/DeltaDistribution.jpg

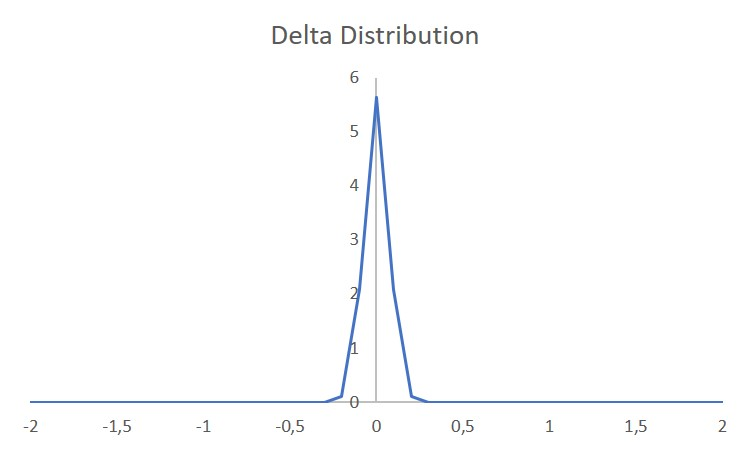
20_Bericht/figures/DeltaDistribution.jpg
