TimGotzel/Stumpfkoerper-WS-18-19/20_Bericht/figures/DModell3.jpg

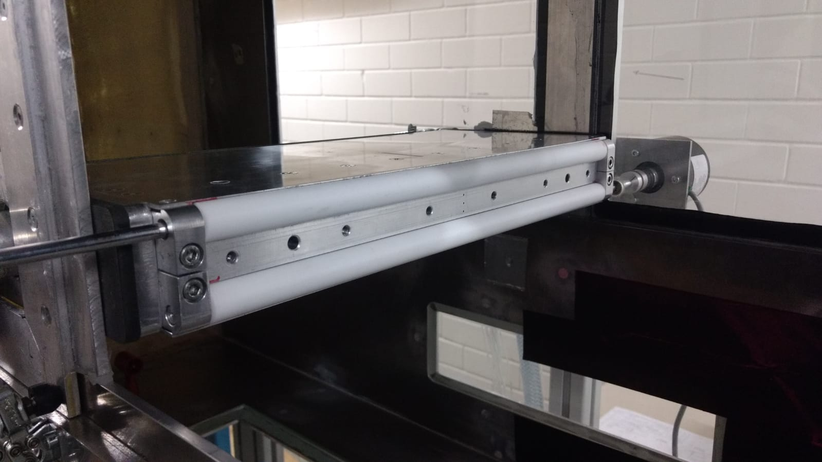
20_Bericht/figures/DModell3.jpg
