TimGotzel/Stumpfkoerper-WS-18-19/20_Bericht/figures/geplanteZahnform.jpg

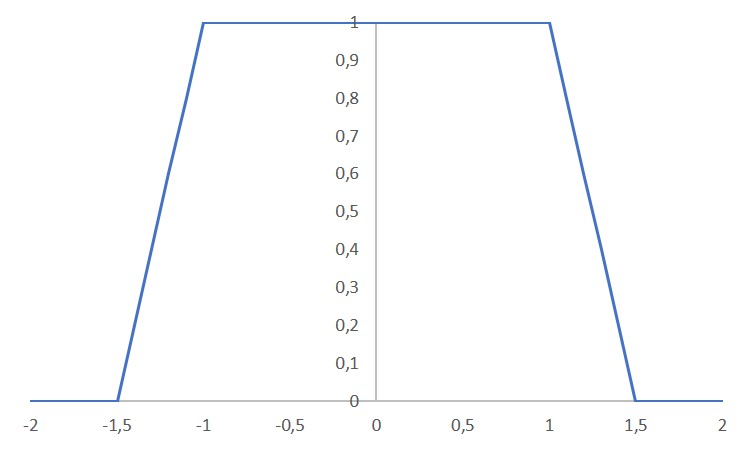
20_Bericht/figures/geplanteZahnform.jpg
