TimGotzel/Stumpfkoerper-WS-18-19/20_Bericht/figures/Heaviside.jpg

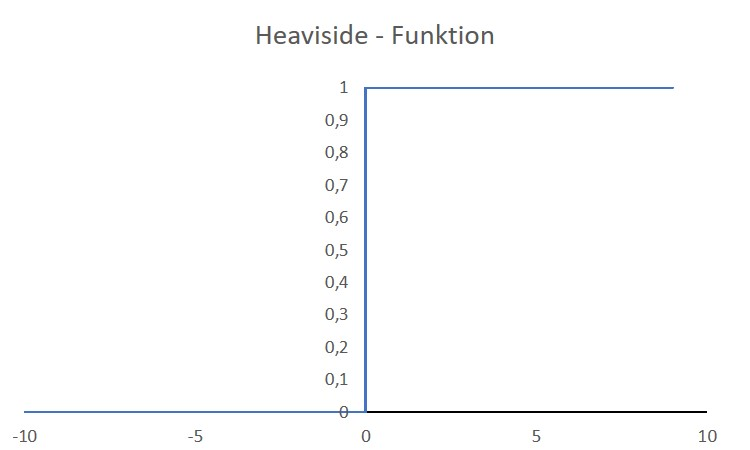
20_Bericht/figures/Heaviside.jpg
