TimGotzel/Stumpfkoerper-WS-18-19/20_Bericht/figures/Oberflaechendruckverteilung50.jpg

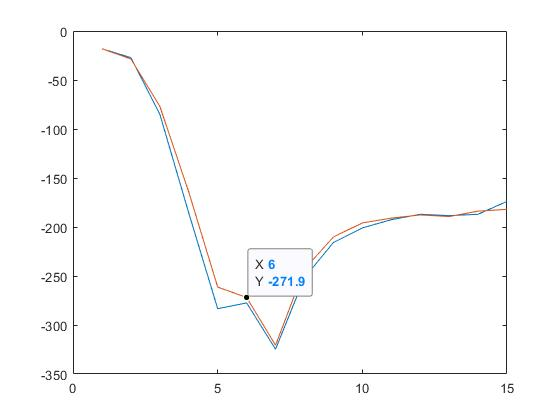
20_Bericht/figures/Oberflaechendruckverteilung50.jpg
