TimGotzel/Stumpfkoerper-WS-18-19/20_Bericht/figures/Scherschicht.jpg

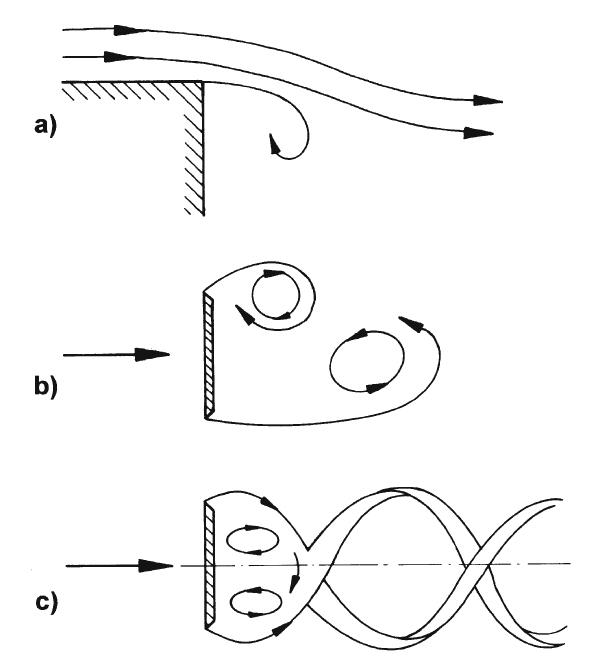
20_Bericht/figures/Scherschicht.jpg
