TimGotzel/Stumpfkoerper-WS-18-19/20_Bericht/figures/Sinus.jpg

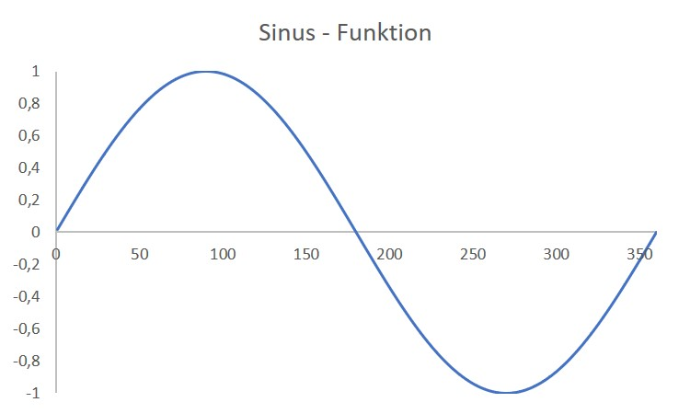
20_Bericht/figures/Sinus.jpg
