TimGotzel/Stumpfkoerper-WS-18-19/20_Bericht/figures/Vorderkante2.jpg

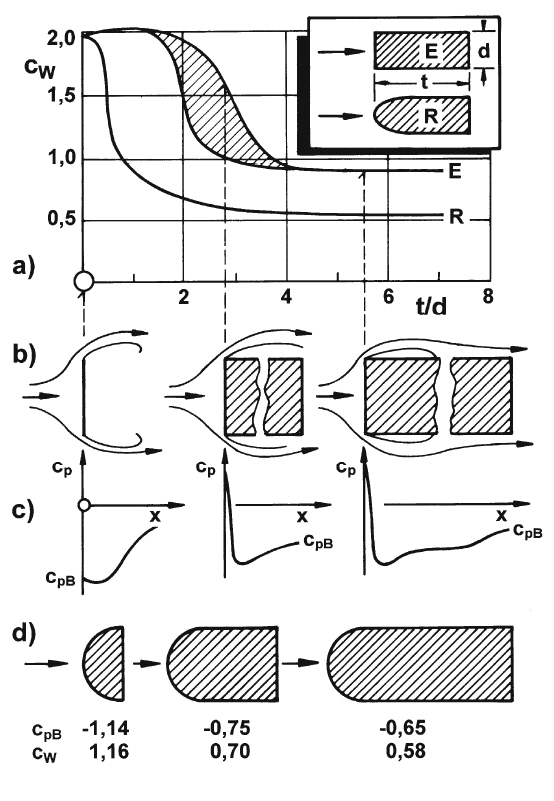
20_Bericht/figures/Vorderkante2.jpg
