TimGotzel/Stumpfkoerper-WS-18-19/21_Bilder Versuch/20181214_155755.jpg

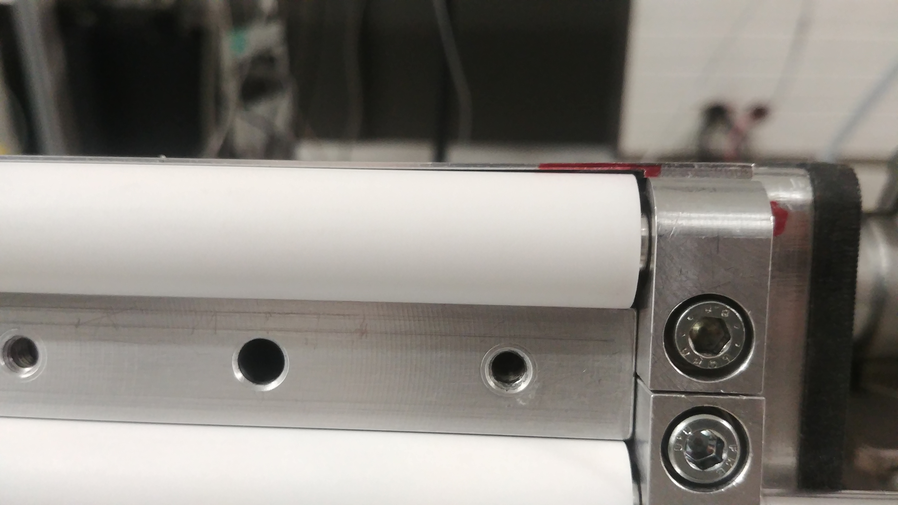
21_Bilder Versuch/20181214_155755.jpg
