TimGotzel/Stumpfkoerper-WS-18-19/21_Bilder Versuch/20181219_094241_HDR.jpg

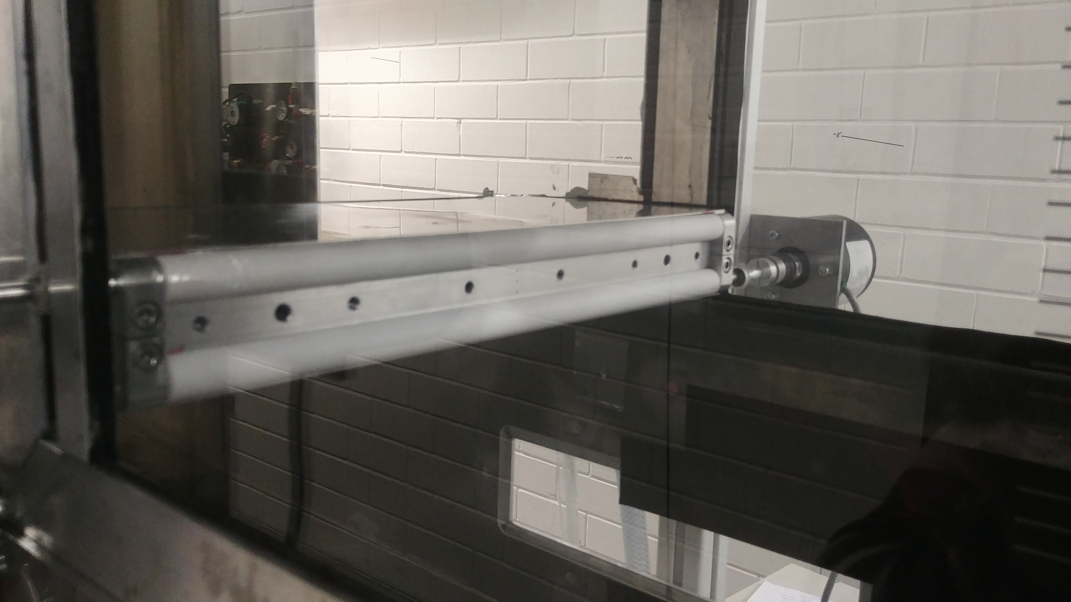
21_Bilder Versuch/20181219_094241_HDR.jpg
