TimGotzel/Stumpfkoerper-WS-18-19/21_Bilder Versuch/20181219_094312.jpg

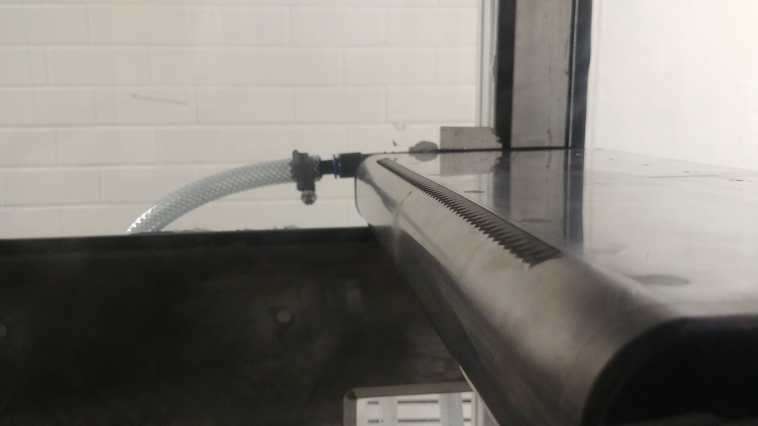
21_Bilder Versuch/20181219_094312.jpg
