TimGotzel/Stumpfkoerper-WS-18-19/21_Bilder Versuch/20181220_132508.jpg

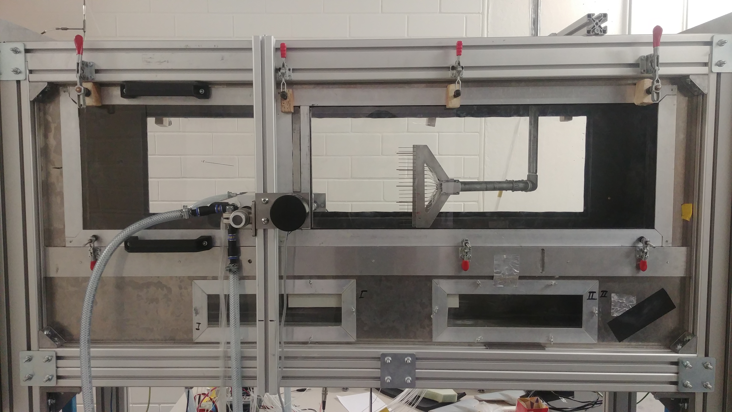
21_Bilder Versuch/20181220_132508.jpg
