TimGotzel/Stumpfkoerper-WS-18-19/21_Bilder Versuch/IMG-20181221-WA0002.jpg

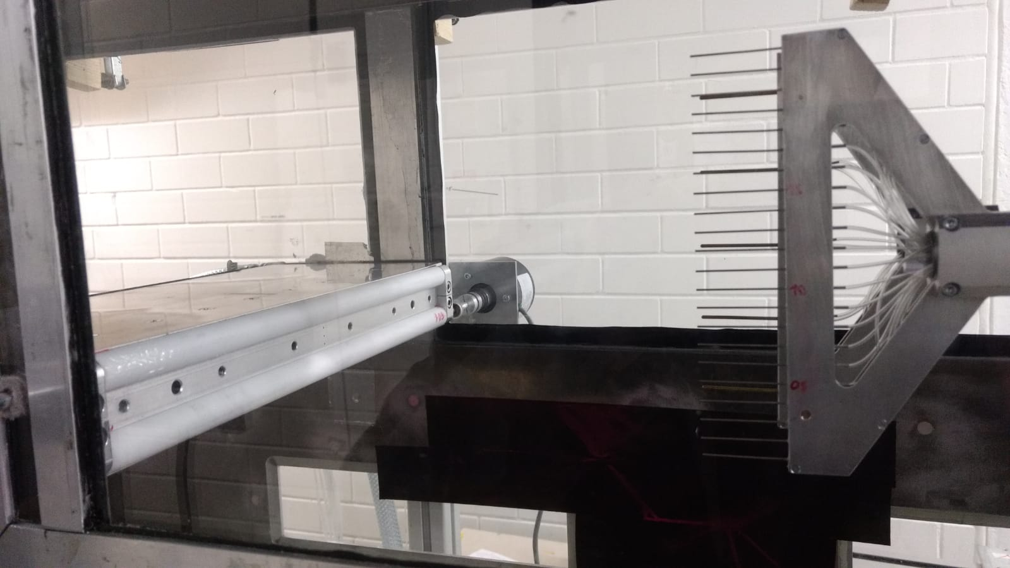
21_Bilder Versuch/IMG-20181221-WA0002.jpg
