TimGotzel/Stumpfkoerper-WS-18-19/21_Bilder Versuch/IMG-20190110-WA0003.jpg

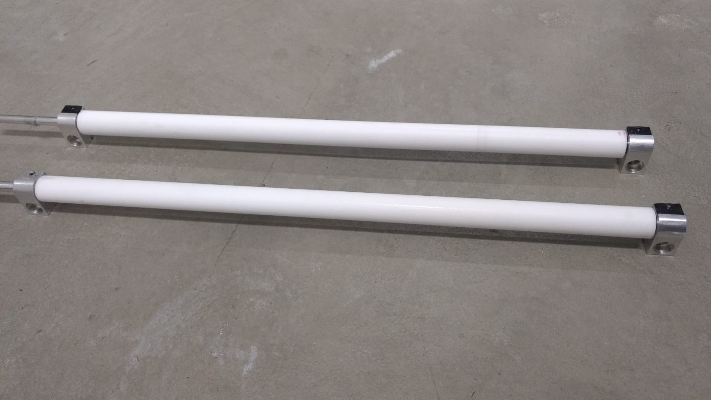
21_Bilder Versuch/IMG-20190110-WA0003.jpg
