TimGotzel/Stumpfkoerper-WS-18-19/40_Messung/Projektarbeit_WS_18_19/Diagramme/Cw_ueber_n_ohneAB_oval.jpg

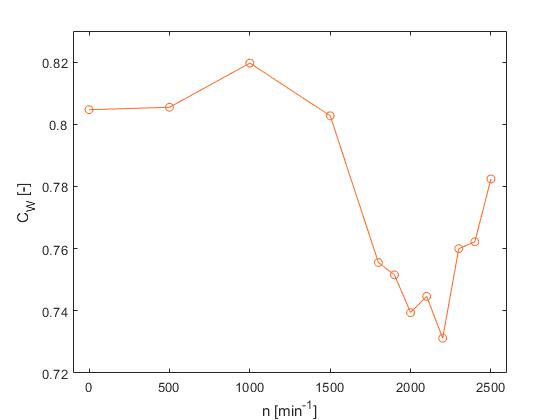
40_Messung/Projektarbeit_WS_18_19/Diagramme/Cw_ueber_n_ohneAB_oval.jpg
