TimGotzel/Stumpfkoerper-WS-18-19/40_Messung/Projektarbeit_WS_18_19/Diagramme/DeltaCw_ueber_C_PowerM_ohne_AB_RK.jpg

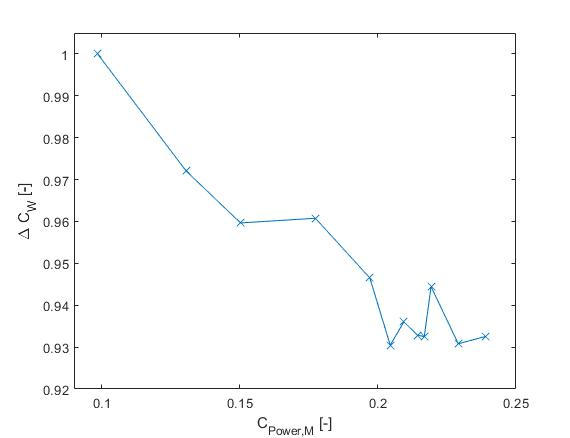
40_Messung/Projektarbeit_WS_18_19/Diagramme/DeltaCw_ueber_C_PowerM_ohne_AB_RK.jpg
