TimGotzel/Stumpfkoerper-WS-18-19/40_Messung/Projektarbeit_WS_18_19/Diagramme/Kombinierte Aktuation/CwCwrefmu_ueber_CPowerM_fuerCPowerJ_RK.jpg

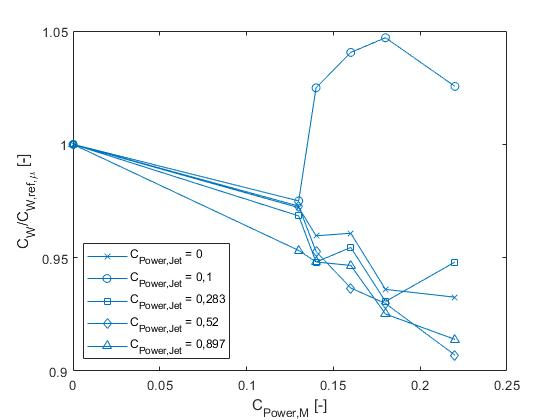
40_Messung/Projektarbeit_WS_18_19/Diagramme/Kombinierte Aktuation/CwCwrefmu_ueber_CPowerM_fuerCPowerJ_RK.jpg
