TimGotzel/Stumpfkoerper-WS-18-19/40_Messung/Projektarbeit_WS_18_19/Diagramme/Kombinierte Aktuation/CwCwrefn_ueberCPowerJ_fuer_n_50.jpg

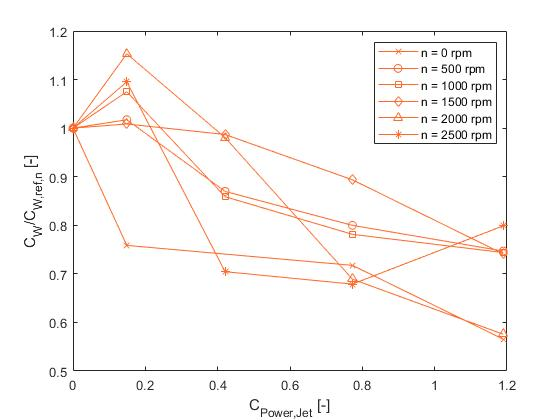
40_Messung/Projektarbeit_WS_18_19/Diagramme/Kombinierte Aktuation/CwCwrefn_ueberCPowerJ_fuer_n_50.jpg
