TimGotzel/Stumpfkoerper-WS-18-19/40_Messung/Projektarbeit_WS_18_19/Diagramme/Kombinierte Aktuation/Motorleistung_ueber_n_fuer_Cmu_50.jpg

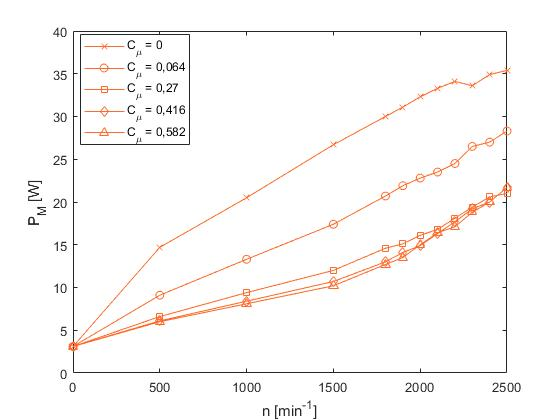
40_Messung/Projektarbeit_WS_18_19/Diagramme/Kombinierte Aktuation/Motorleistung_ueber_n_fuer_Cmu_50.jpg
