TimGotzel/Stumpfkoerper-WS-18-19/60_Review 2/Scan 19.JPG

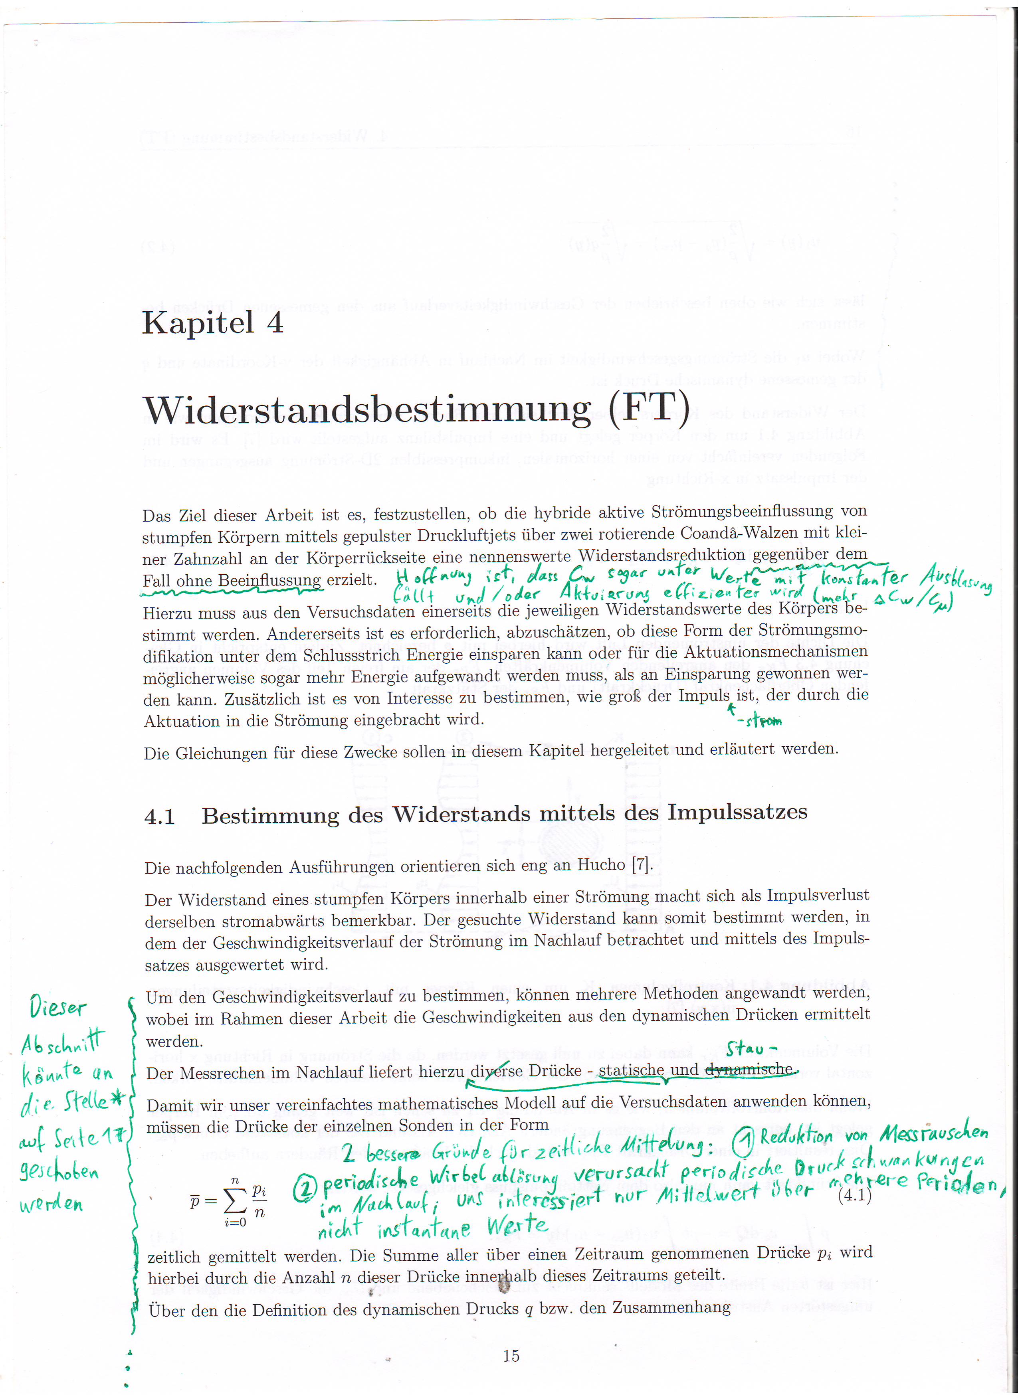
60_Review 2/Scan 19.JPG
