TimGotzel/Stumpfkoerper-WS-18-19/60_Review 2/Scan 29.JPG

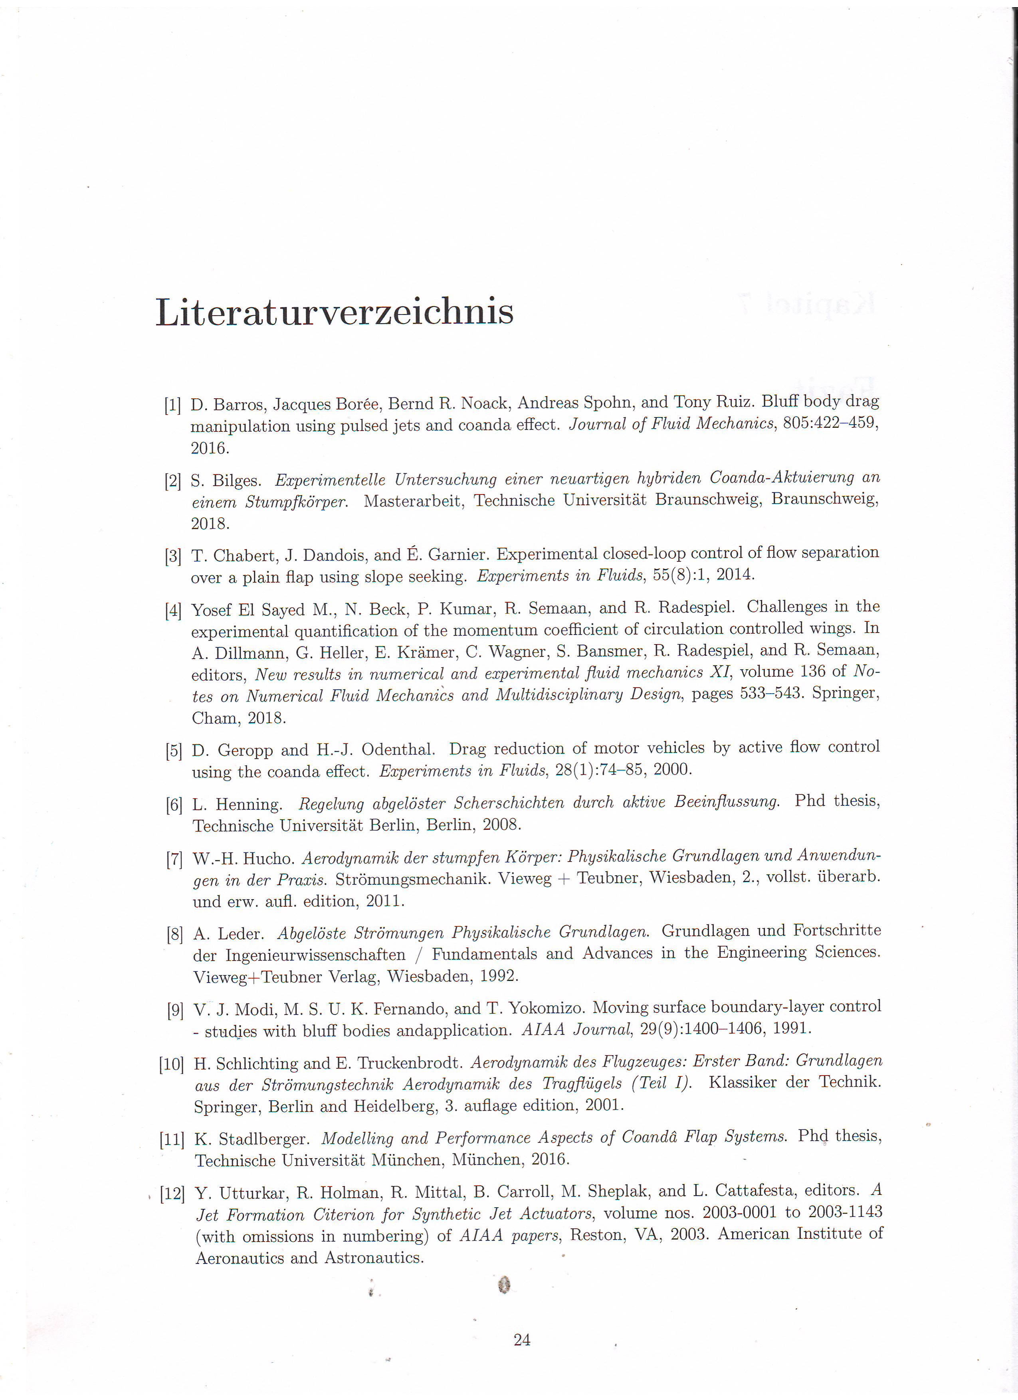
60_Review 2/Scan 29.JPG
