TimGotzel/Stumpfkoerper-WS-18-19/70_Poster/Bilder/CD_Cw_ueber_n_fuer_verschiedeneCmu_50.jpg

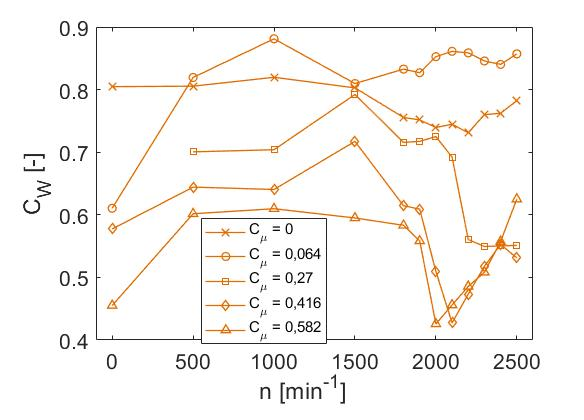
70_Poster/Bilder/CD_Cw_ueber_n_fuer_verschiedeneCmu_50.jpg
