TimGotzel/Stumpfkoerper-WS-18-19/70_Poster/Bilder/t.jpg

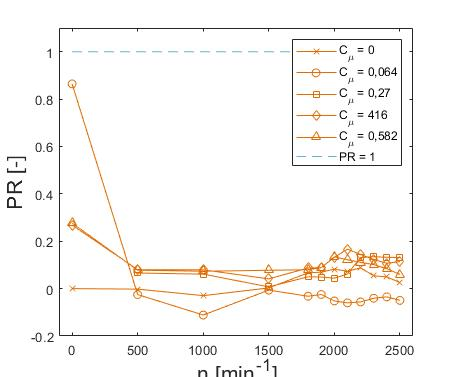
70_Poster/Bilder/t.jpg
