TimGotzel/Stumpfkoerper-WS-18-19/90_Widerstandsbestimmung/Impulskoeffizient Energiekoeffizient Seite 1.jpeg

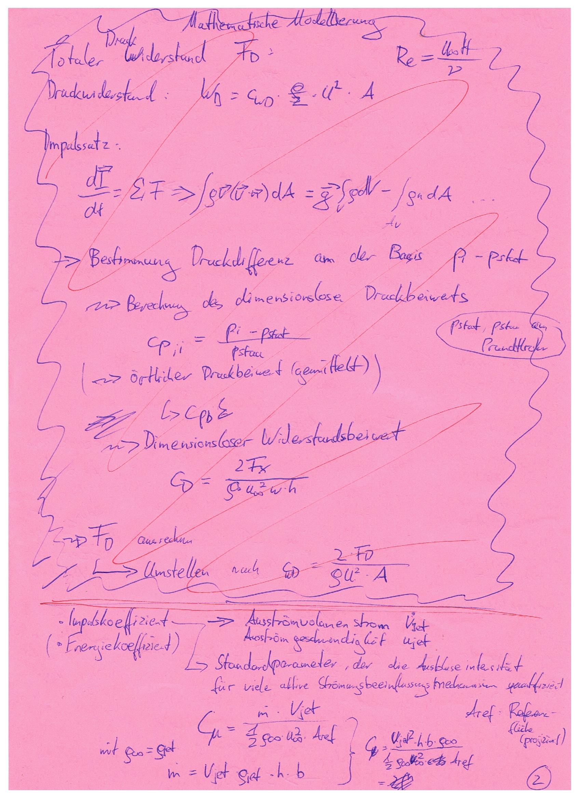
90_Widerstandsbestimmung/Impulskoeffizient Energiekoeffizient Seite 1.jpeg
