TimGotzel/Stumpfkoerper-WS-18-19/90_Widerstandsbestimmung/Impulskoeffizient Energiekoeffizient Seite 2.jpeg.jpeg

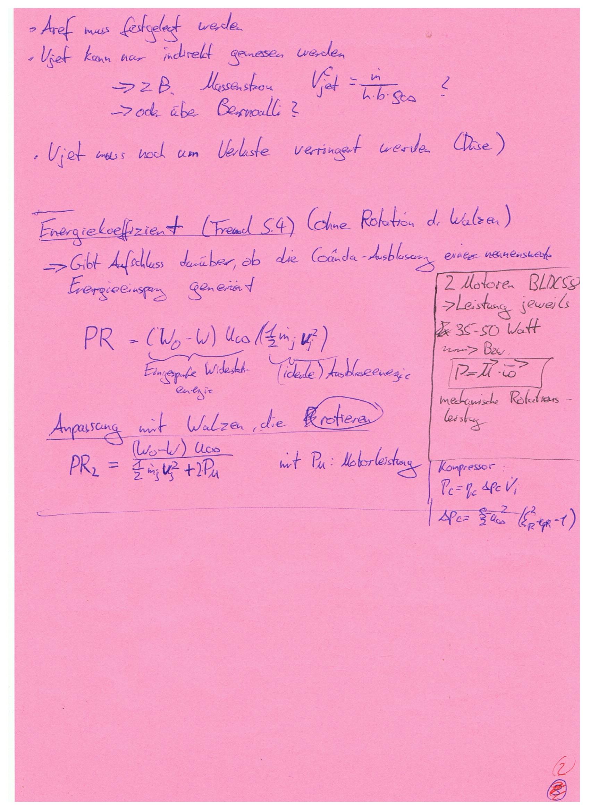
90_Widerstandsbestimmung/Impulskoeffizient Energiekoeffizient Seite 2.jpeg.jpeg
