TimGotzel/Stumpfkoerper-WS-18-19/90_Widerstandsbestimmung/Widerstandsbestimmung (Impulssatz) Seite 2.jpeg

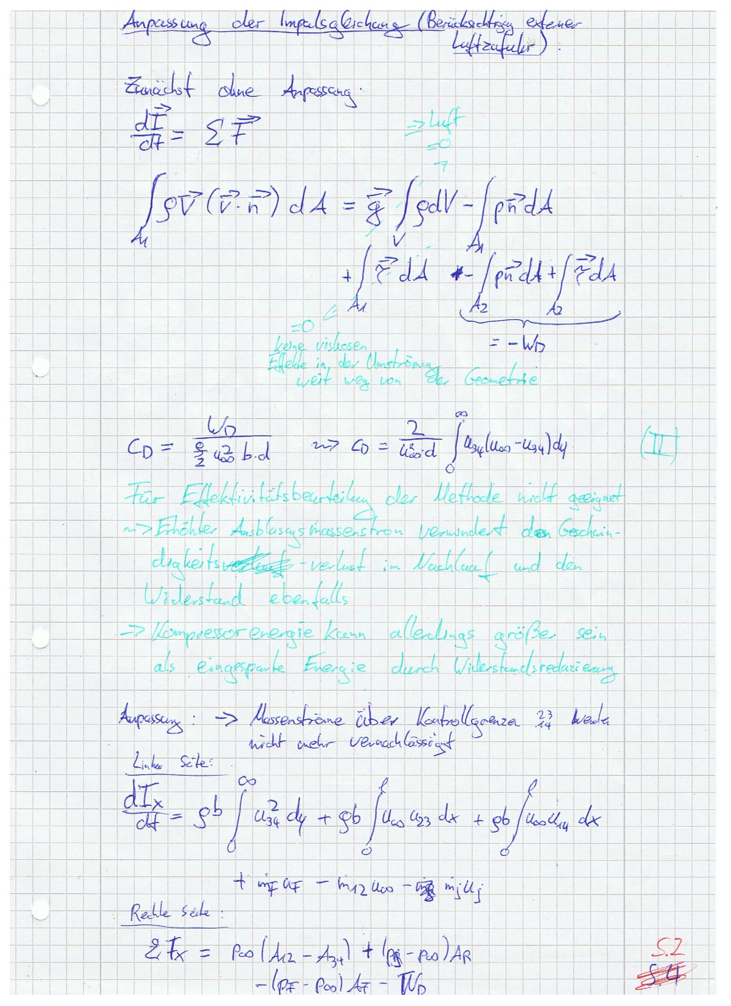
90_Widerstandsbestimmung/Widerstandsbestimmung (Impulssatz) Seite 2.jpeg
