TimGotzel/Stumpfkoerper-WS-18-19/90_Widerstandsbestimmung/Widerstandsbestimmung Seite 1.jpeg

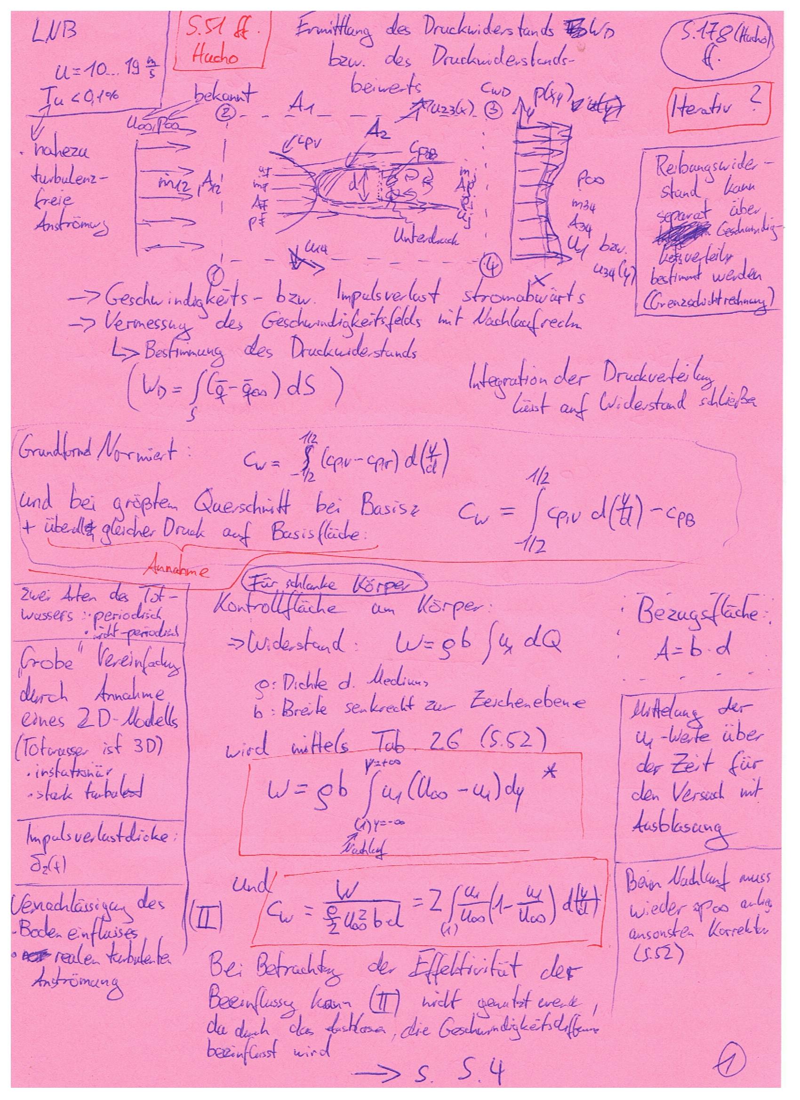
90_Widerstandsbestimmung/Widerstandsbestimmung Seite 1.jpeg
