TimGotzel/Stumpfkoerper-WS-18-19/(list of files, cad)

Other CAD files:
30_CAD/WALZE.CATProduct
30_CAD/WALZE33.CATProduct
30_CAD/WALZE_Innenwelle.CATPart
30_CAD/WALZE_gezahnteWelle.CATPart
30_CAD/WALZE_gezahnteWelle33.CATPart
