TimGotzel/Stumpfkoerper-WS-18-19/40_Messung/Projektarbeit_WS_18_19/Daten/test.txt

13:48:16	0,7923	1,0718	0,3781	0,0329	0,1249	0,0723	-1,1737	-1,1605	-0,2926	-0,8186	-1,4992	-0,7266	-1,1671	-1,2296	-0,2071	-0,4603	-0,5721	-1,3447	-0,4603	-0,7233	-0,6510	-0,8055	-0,0362	-0,4899	-0,2827	-0,3978	-0,4142	-0,7167	-0,6312	-1,0027	-1,3973	-0,3485	890,3685	1192,6572	17,4674	-8,6006	1,6669	-4,4877	8,9523	6,3715	13,7326	0,4899	2,6860	12,7299	1,9496	7,2428	-7,4137	29,7009	1,8575	-0,7595	4,6126	11,8356	16,7474	16,5633	3,2121	4,2970	5,7436	-1,1507	13,0389	21,8861	21,7809	0,8745	-12,4143	8,9491	18,6557
13:48:16	1,9989	0,5162	-0,2038	-0,1512	-0,2301	-1,0356	-2,3770	-1,4630	-1,0159	-0,5293	-0,2236	-0,6378	-0,4405	-0,5359	-0,5885	-0,1841	-0,1052	-0,8647	-0,3649	-0,0559	-0,1973	-1,0784	-0,9107	-0,3945	-0,0986	-1,0060	-0,4142	-0,0526	-0,2367	-1,0948	-0,4866	-0,8055	899,9817	1162,3876	9,2680	4,9743	28,2116	5,2077	7,6143	10,4976	13,7326	5,9047	-2,7616	5,9375	6,2236	4,3726	14,4033	4,9940	-2,2389	9,2318	4,6126	2,3967	18,1710	11,0433	-2,4099	18,4767	8,4165	23,9704	14,3902	2,8537	9,0214	6,5392	1,0126	17,0466	18,6569
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
