TimGotzel/Stumpfkoerper-WS-18-19/20_Bericht/figures/Mantel_A.pdf

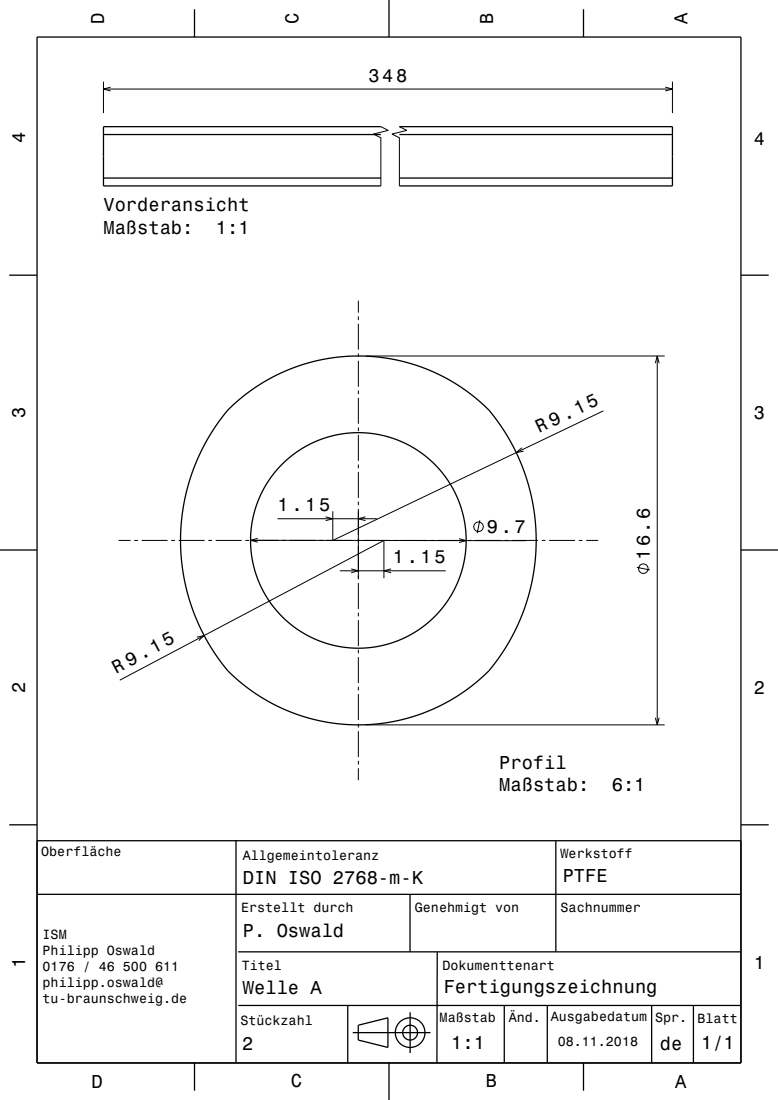
[picture p160: page 1]
Maßstab: 1:1; Maßstab: 6:1

Oberfläche | Allgemeintoleranz DIN ISO 2768-m-K | Werkstoff PTFE

ISM Philipp Oswald 0176 / 46 500 611 philipp.oswald@ tu-braunschweig.de | Erstellt durch P. Oswald | Genehmigt von | Sachnummer

Titel Welle A | Dokumenttenart Fertigungszeichnung

Stückzahl 2 | | | | Maßstab 1:1 | Änd. | Ausgabedatum 08.11.2018 | Spr. de | Blatt 1/1
