TimGotzel/Stumpfkoerper-WS-18-19/20_Bericht/figures/DrawinggezahnteWelle33.pdf

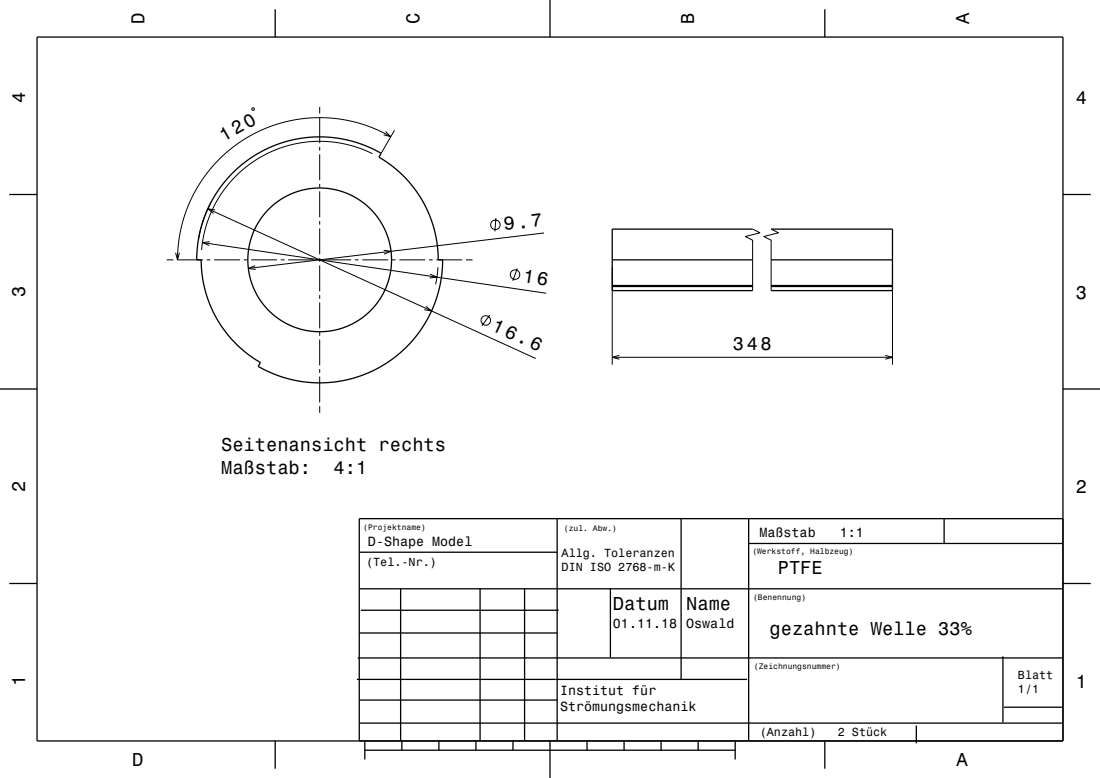
[picture p161: page 1]
(Werkstoff, Halbzeug); D-Shape Model; (zul. Abw.); Allg. Toleranzen DIN ISO 2768-m-K; Seitenansicht rechts Maßstab: 4:1

Datum 01.11.18 | Name Oswald | (Benennung) gezahnte Welle 33%

(Zeichnungsnummer) | Blatt 1/1

Institut für Strömungsmechanik

(Anzahl) 2 Stück
