TimGotzel/Stumpfkoerper-WS-18-19/20_Bericht/figures/DrawinggezahntWelle50.pdf

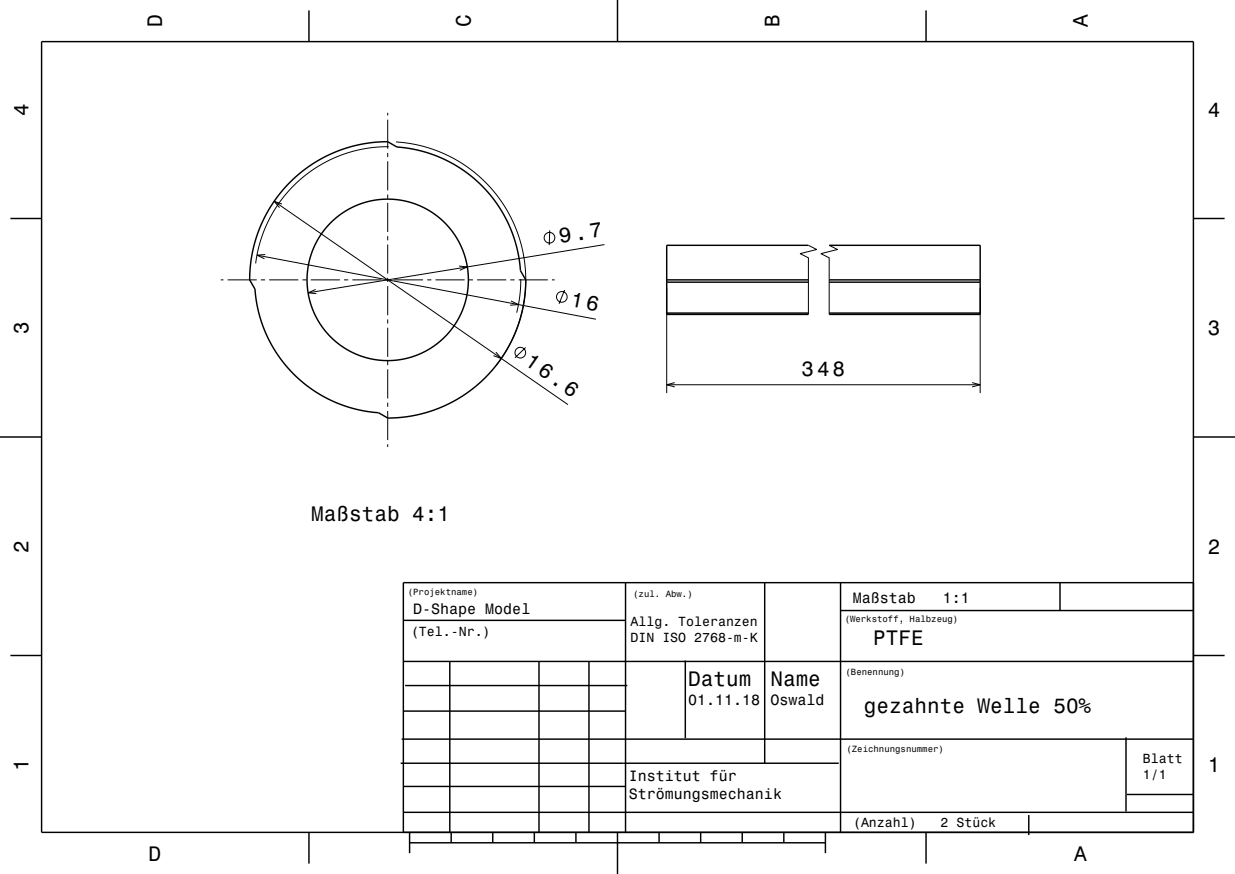
[picture p162: page 1]
(Werkstoff, Halbzeug); D-Shape Model; (zul. Abw.); Allg. Toleranzen DIN ISO 2768-m-K; Maßstab 4:1

Datum 01.11.18 | Name Oswald | (Benennung) gezahnte Welle 50%

(Zeichnungsnummer) | Blatt 1/1

Institut für Strömungsmechanik

(Anzahl) 2 Stück
