TimGotzel/Stumpfkoerper-WS-18-19/20_Bericht/figures/DrawingInnenwelle.pdf

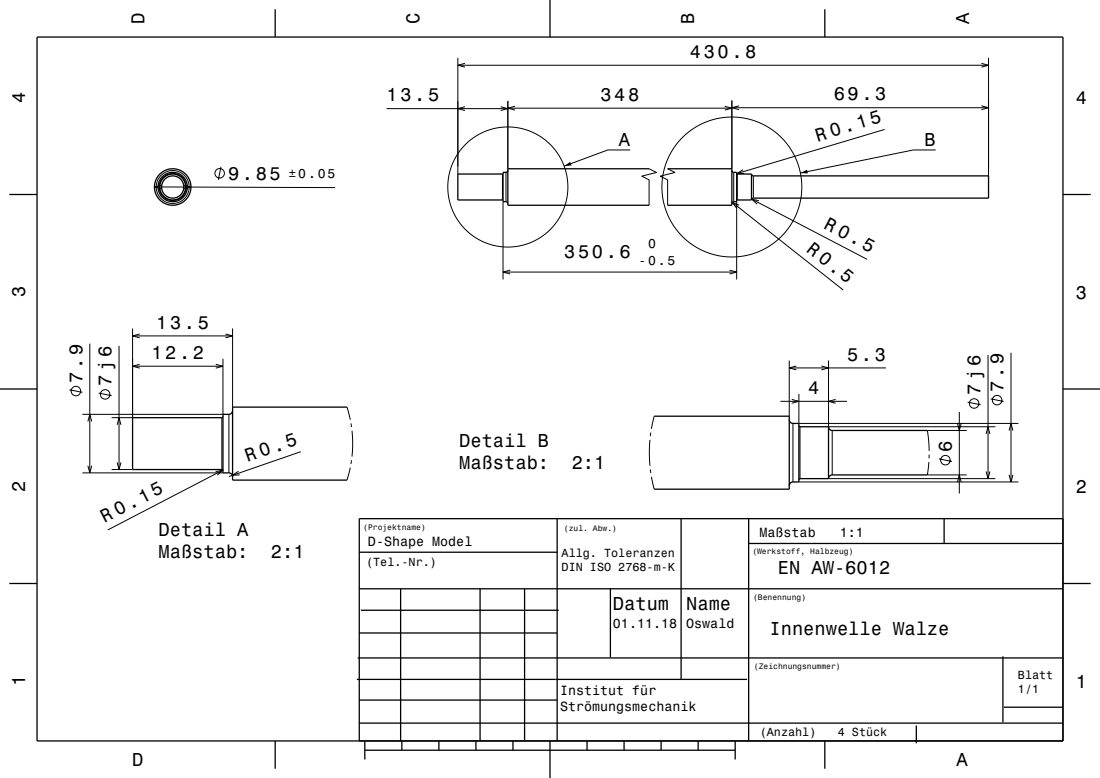
[picture p163: page 1]
(Werkstoff, Halbzeug) EN AW-6012; D-Shape Model; (zul. Abw.); Allg. Toleranzen DIN ISO 2768-m-K; Detail A Maßstab: 2:1; Detail B Maßstab: 2:1

Datum 01.11.18 | Name Oswald | (Benennung) Innenwelle Walze

(Zeichnungsnummer) | Blatt 1/1

Institut für Strömungsmechanik

(Anzahl) 4 Stück
