TimGotzel/Stumpfkoerper-WS-18-19/40_Messung/Projektarbeit_WS_18_19/Literatur/Druckmessbohrungen.pdf

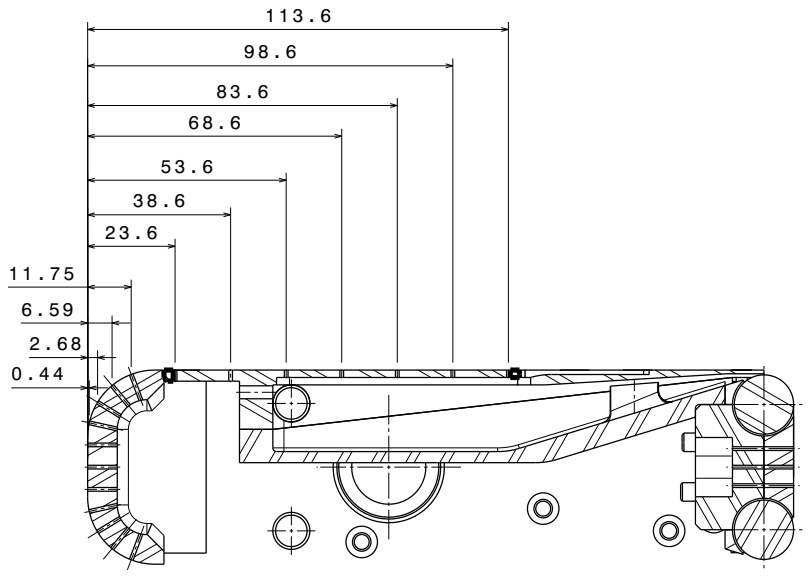
[picture p164: page 1]
