TimGotzel/Stumpfkoerper-WS-18-19/(commit log)

2018-10-19 Ablaufplanung/Guntt-Chart hinzugefügt
    [Projektmanagement_Ablaufplanung_v1.xlsx]
2018-10-25 Überarbeitetes Gantt-Chart hinzugefügt
    [Time_Schedule_Projektarbeit.xlsx]
2018-10-25 CAD Modell uns Zeichnungen der Walzen
    [WALZE.CATProduct, WALZE_Innenwelle.CATPart, WALZE_gezahnteWelle.CATPart]
2018-11-01 aktuelles CAD Modell
    [WALZE33.CATProduct, WALZE_Innenwelle.CATPart, WALZE_gezahnteWelle.CATPart, WALZE_gezahnteWelle33.CATPart]
2018-11-06 CAD Model 3.0
    [WALZE_Innenwelle.CATPart, WALZE_gezahnteWelle.CATPart, WALZE_gezahnteWelle33.CATPart]
2018-12-17 Messdaten der 50% Wellen hinzugefügt
2018-12-21 Daten der Messkampagne hinzugefügt
    [C_mu_50erWellen.xlsx, Cmüh.xlsx]
2019-01-06 Nomenklatur aktualisiert und Matrikelnummer ergänzt
2019-01-10 Modellbeschreibung & Bilder
    [C_mu_50erWellen.xlsx, Cmüh.xlsx, Projektmanagement_Ablaufplanung_v1.xlsx, Time_Schedule_Projektarbeit.xlsx, WALZE.CATProduct, WALZE33.CATProduct, WALZE_Innenwelle.CATPart, WALZE_gezahnteWelle.CATPart]
2019-01-10 Restructuring Modellabschnitt
    Passt das an die Stelle? Kebria, geht das so?
2019-01-11 p-Mittelwerte + MATLABCODES + DIAGRAMME
    [0kPa0rpm.xlsx, 0kPa1000rpm_01.xlsx, 0kPa1000rpm_02.xlsx, 0kPa1000rpm_03.xlsx, 0kPa1000rpm_04.xlsx, 0kPa1000rpm_05.xlsx, 0kPa1500rpm_01.xlsx, 0kPa1500rpm_02.xlsx]
2019-01-11 Kapitel 4 leicht überarbeitet + Cw-Werte(50er)
    [0kPa0rpm.Cw_Werte.xlsx, 0kPa1000rpm_01.Cw_Werte.xlsx, 0kPa1000rpm_02.Cw_Werte.xlsx, 0kPa1000rpm_03.Cw_Werte.xlsx, 0kPa1000rpm_04.Cw_Werte.xlsx, 0kPa1000rpm_05.Cw_Werte.xlsx, 0kPa1500rpm_01.Cw_Werte.xlsx, 0kPa1500rpm_02.Cw_Werte.xlsx]
2019-01-11 Änderungen Kap4&6 + Finale C_w-Werte 50er
    [0kPa0rpm.Cw_Werte.xlsx, 0kPa0rpm.xlsx, 0kPa500rpm_01.Cw_Werte.xlsx, 0kPa500rpm_01.xlsx, 0kPa500rpm_02.Cw_Werte.xlsx, 0kPa500rpm_02.xlsx, 0kPa500rpm_03.Cw_Werte.xlsx, 0kPa500rpm_03.xlsx]
2019-01-11 Überflüssige Spreadsheets gelöscht
    [0kPa0rpm.Cw_Werte.xlsx, 0kPa1000rpm_01.Cw_Werte.xlsx, 0kPa1000rpm_02.Cw_Werte.xlsx, 0kPa1000rpm_03.Cw_Werte.xlsx, 0kPa1000rpm_04.Cw_Werte.xlsx, 0kPa1000rpm_05.Cw_Werte.xlsx, 0kPa1500rpm_01.Cw_Werte.xlsx, 0kPa1500rpm_02.Cw_Werte.xlsx]
2019-01-12 Stand der letzten Zwischenabgabe
2019-01-12 Werte für C_Power und Abb. für Reine Rotation
    [C_Power_M.xlsx, P_M.xlsx, P_M_0kPa.xlsx, P_M_1kPa.xlsx, P_M_2kPa.xlsx, P_M_3kPa.xlsx, P_M_4kPa.xlsx]
2019-01-12 Versuchsteil in Kap5 geschoben + Abb für Reine Ausblasung
    [C_mu-Werte.xlsx]
2019-01-12 1. Abb. für Kombinierte Aktuation
    [Cw_Werte_ges(RK).xlsx]
2019-01-13 Kap4 und Abb: PR über n
2019-01-13 Abb. für Kombinierte Akt.
    [C_Power_M_ges(RK).xlsx, Cw_Werte_ges(50).xlsx]
2019-01-13 Abb für Kombi
    [P_M.xlsx]
2019-01-14 Oberfläcehendrücke in Kapitel 5 hinzugefügt
    [C_Power_M_ges(RK).xlsx, Cw_Werte_ges(RK).xlsx]
2019-01-14 Abbildungen für Kapitel 6+ Änderungen an Kap 6
    [C_mu_50erWellen.xlsx]
2019-01-14 Noch ein paar Abbildungen
    [C_mu-Werte.xlsx, Cw_Werte_ges(50).xlsx, P_M50.xlsx]
2019-01-15 Änderungen Kapitel 6 und 5
2019-01-15 Abstract und Fazit
2019-01-15 Version der Abgabe
2019-01-20 PDF-Version des Posters
